chirimen-oh/echigo-release/README.md

# [release](https://github.com/chirimen-oh/release/releases)
This is [release](https://github.com/chirimen-oh/release/releases) repository for CHIRIMEN

[CHIRIMEN Open Hardware Project Home Page](http://chirimen-oh.github.io)
