chirimen-oh/echigo-release/hardware/README.md

Information required in order to manufacture CHIRIMEN hardware CMN2015-1 is founded here. 

- CMN2015-1_BOM.pdf : BOM (PDF)
- CMN2015-1_BOM.xlsx : BOM (Excel sheet)
- CMN2015-1_gerber.zip : Gerber data
- CMN2015-1_printPattern.pdf : Print pattern PDF
- CMN2015-1_schematic.pdf : Schematic PDF
- CMN2015-1.pcb : Source PCB file for PADS CAD.
- README.md : This file

Note: CAD DATA is published! 6.10.2016
