chirimen-oh/echigo-release/hardware/CMN2015-1_schematic.pdf

# 05.5V DC in/LED

# 07.USB/OTG/Crystal/Debug

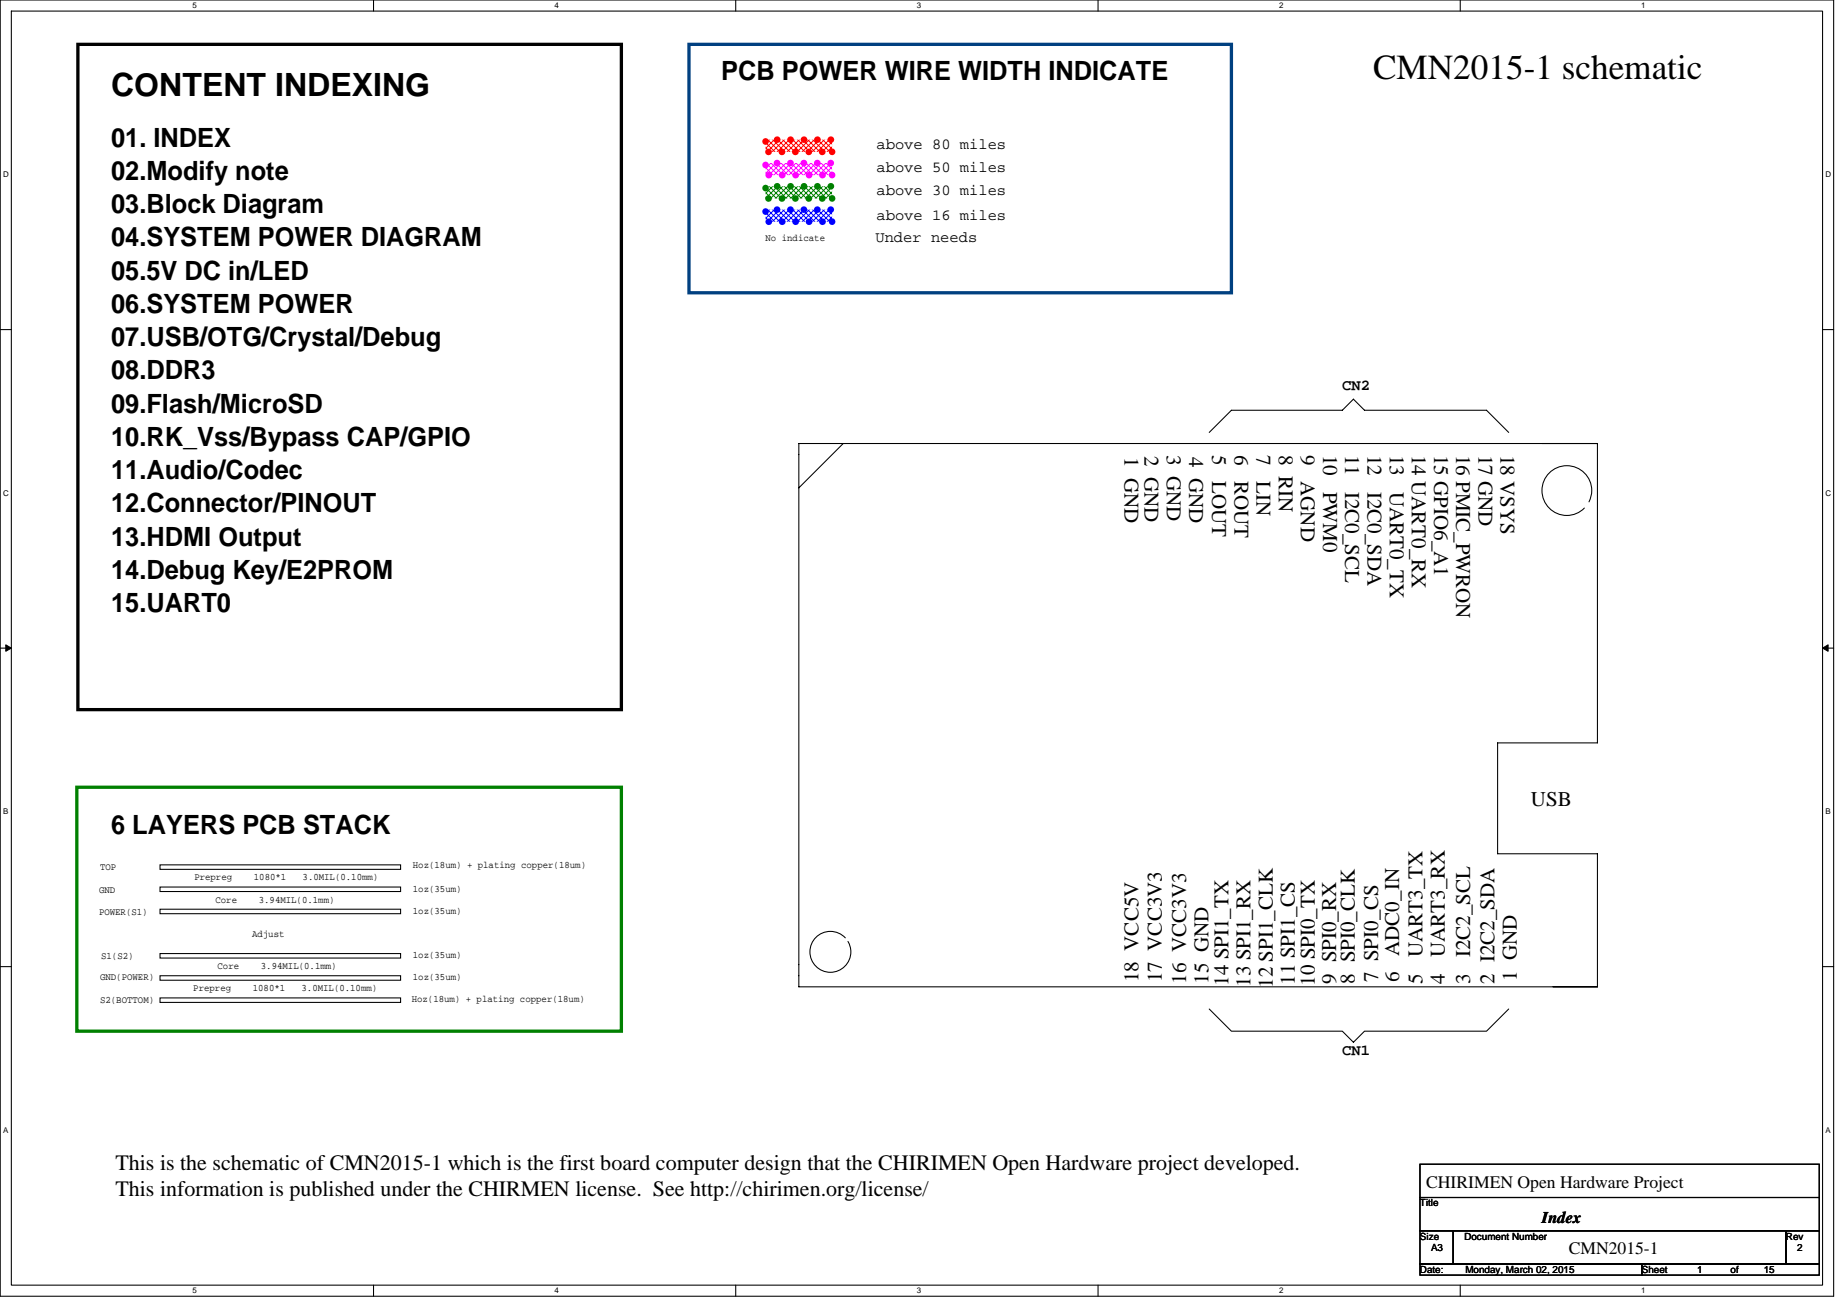
[picture p1: page 1]
06.SYSTEM POWER; above 80 miles above 50 miles; above 16 miles; above 30 miles; No indicate; Under needs; Prepreg; 3.0MIL(0.10mm); Core; 3.94MIL(0.1mm); Adjust; GND; GND(POWER); S2(BOTTOM); TOP; POWER(S1); 5 LOUT; 6 ROUT; 7 LIN; 8 RIN; 9 AGND; 10 PWM0; 11 I2C0_SCL; 12 I2C0_SDA; 13 UART0_TX; 14 UART0_RX; 15 GPIO6_A1; 16 PMIC_PWRON; 17 GND; 18 VSYS; 14 SPI1_TX; 13 SPI1_RX; 12 SPI1_CLK 11 SPI1_CS; 10 SPI0_TX 9 SPI0_RX; 8 SPI0_CLK 7 SPI0_CS; 6 ADC0_IN; 5 UART3_TX; 4 UART3_RX; 3 I2C2_SCL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

PCB POWER WIRE WIDTH INDICATE

CONTENT INDEXING
01. INDEX
02.Modify note
03.Block Diagram
04.SYSTEM POWER DIAGRAM

08.DDR3
09.Flash/MicroSD
10.RK_Vss/Bypass CAP/GPIO
11.Audio/Codec
12.Connector/PINOUT
13.HDMI Output
14.Debug Key/E2PROM
15.UART0

6 LAYERS PCB STACK

Hoz(18um) + plating copper(18um)

This is the schematic of CMN2015-1 which is the first board computer design that the CHIRIMEN Open Hardware project developed.
This information is published under the CHIRMEN license. See http://chirimen.org/license/

CHIRIMEN Open Hardware Project

Size A3 | Document Number CMN2015-1 | Rev

Date: Monday, March 02, 2015 Monday, March 02, 2015 Monday, March 02, 2015 | Sheet 1 1 1 of 15 15 15

D | D
C | C
B | B
A | A
Version | Date | Author | Change Note | Note
V1 | 20150108 | Dawen | First edictor
V2 | 20150302 | Dawen | INARI to CHIRIMEN, Add Power&Ground PIN

# Modify note

Monday, March 02, 2015 | 2 | 15

# Modify note

Monday, March 02, 2015 | 2 | 15

# Modify note

Monday, March 02, 2015 | 2 | 15

## CHIRIMEN Open Hardware Project

# SDIO1

I2C3

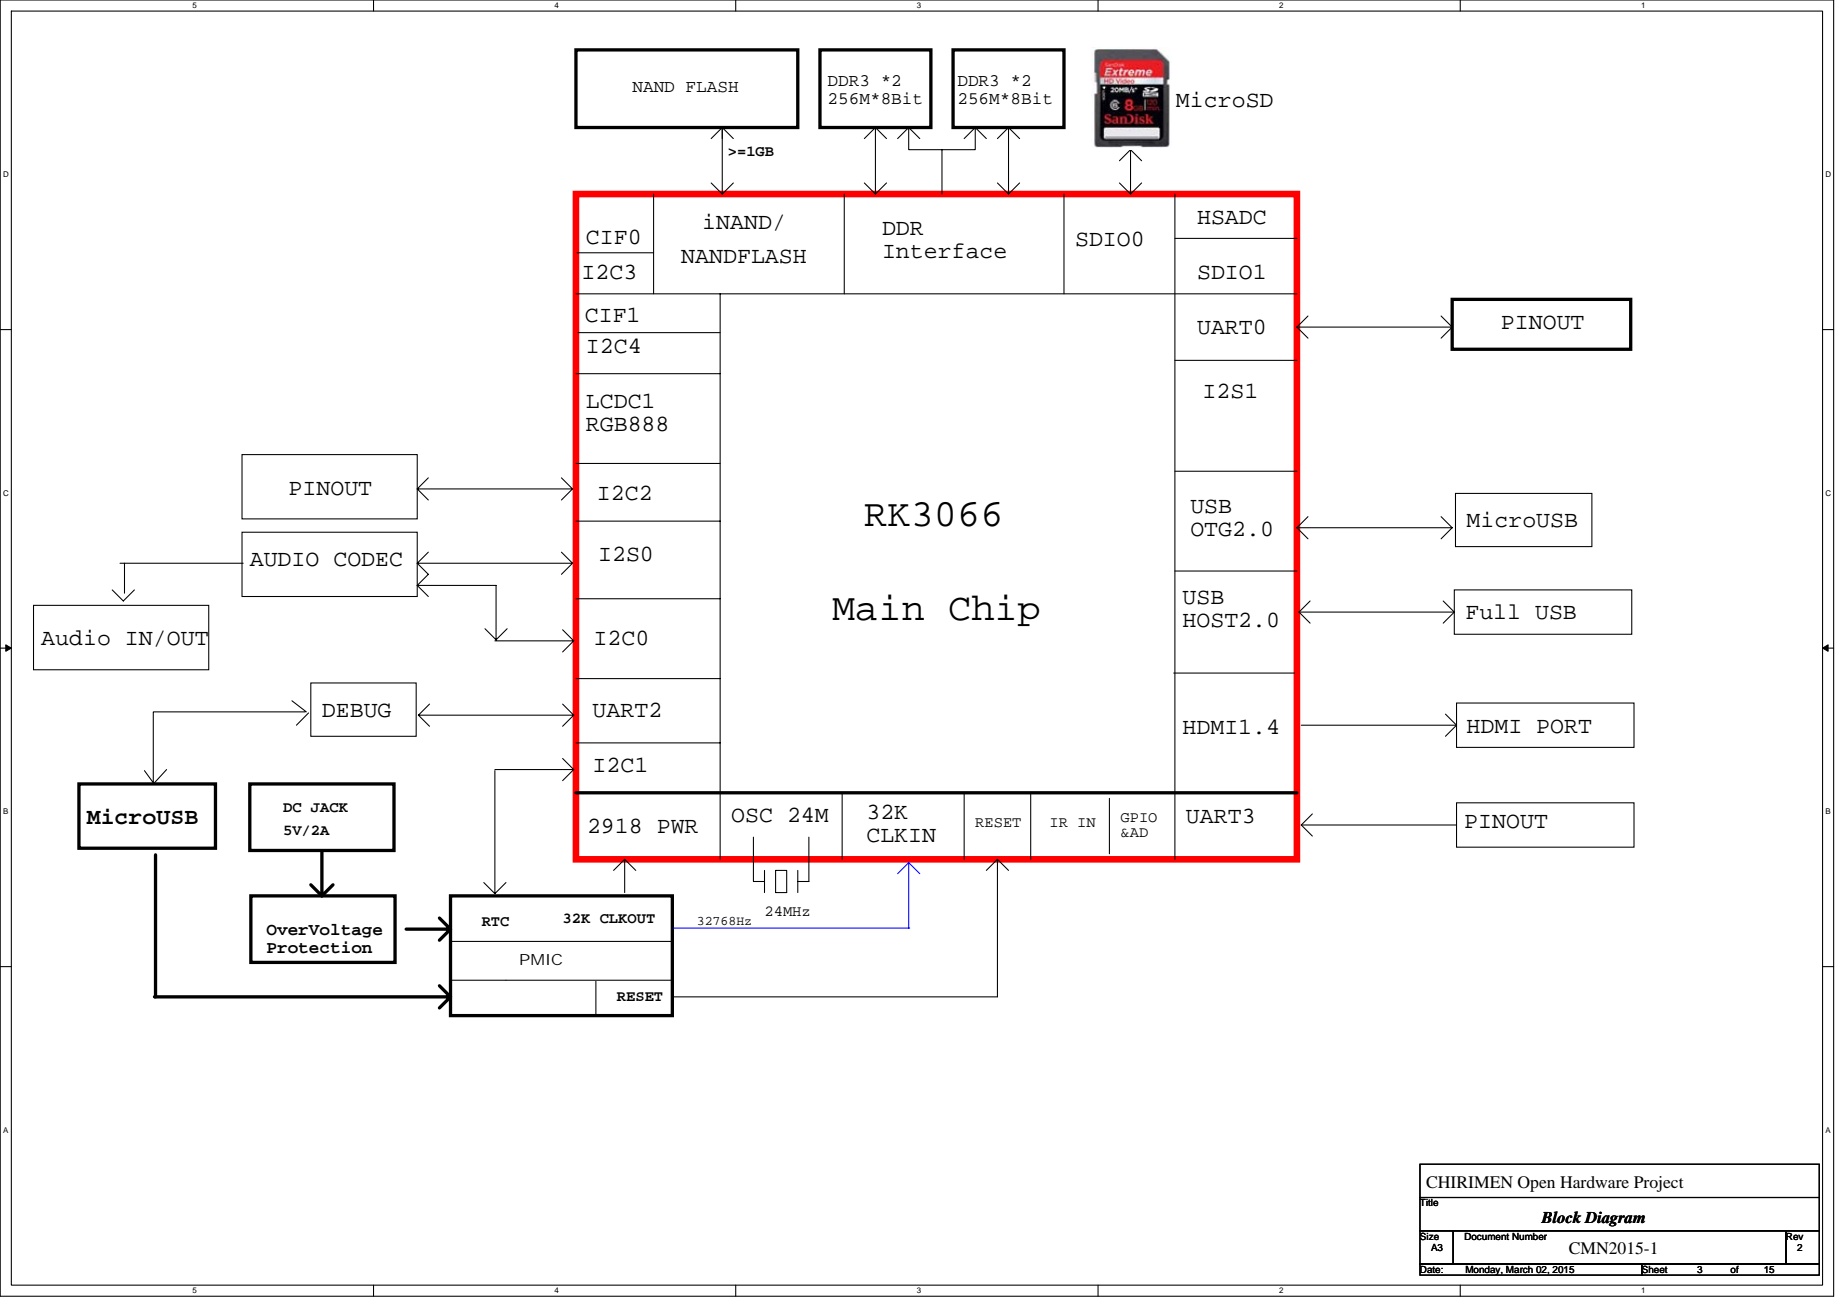
[picture p2: page 3]
2918 PWR; UART2; LCDC1 RGB888; NAND FLASH; DDR3 *2 256M*8Bit; 24MHz; OSC 24M; CLKIN; UART0; USB OTG2.0; iNAND/; RESET; USB HOST2.0; NANDFLASH; PMIC; DDR Interface; OverVoltage Protection; CIF0; SDIO0; HSADC; Full USB; CIF1 I2C4; PINOUT; AUDIO CODEC; DEBUG; DC JACK 5V/2A; RTC; 32K CLKOUT; HDMI1.4; HDMI PORT; GPIO; UART3; MicroUSB; Main Chip; MicroSD; Block Diagram; Monday, March 02, 2015

Audio IN/OUT

CHIRIMEN Open Hardware Project

## VDD1

VCC2 | DCDC | VDD2

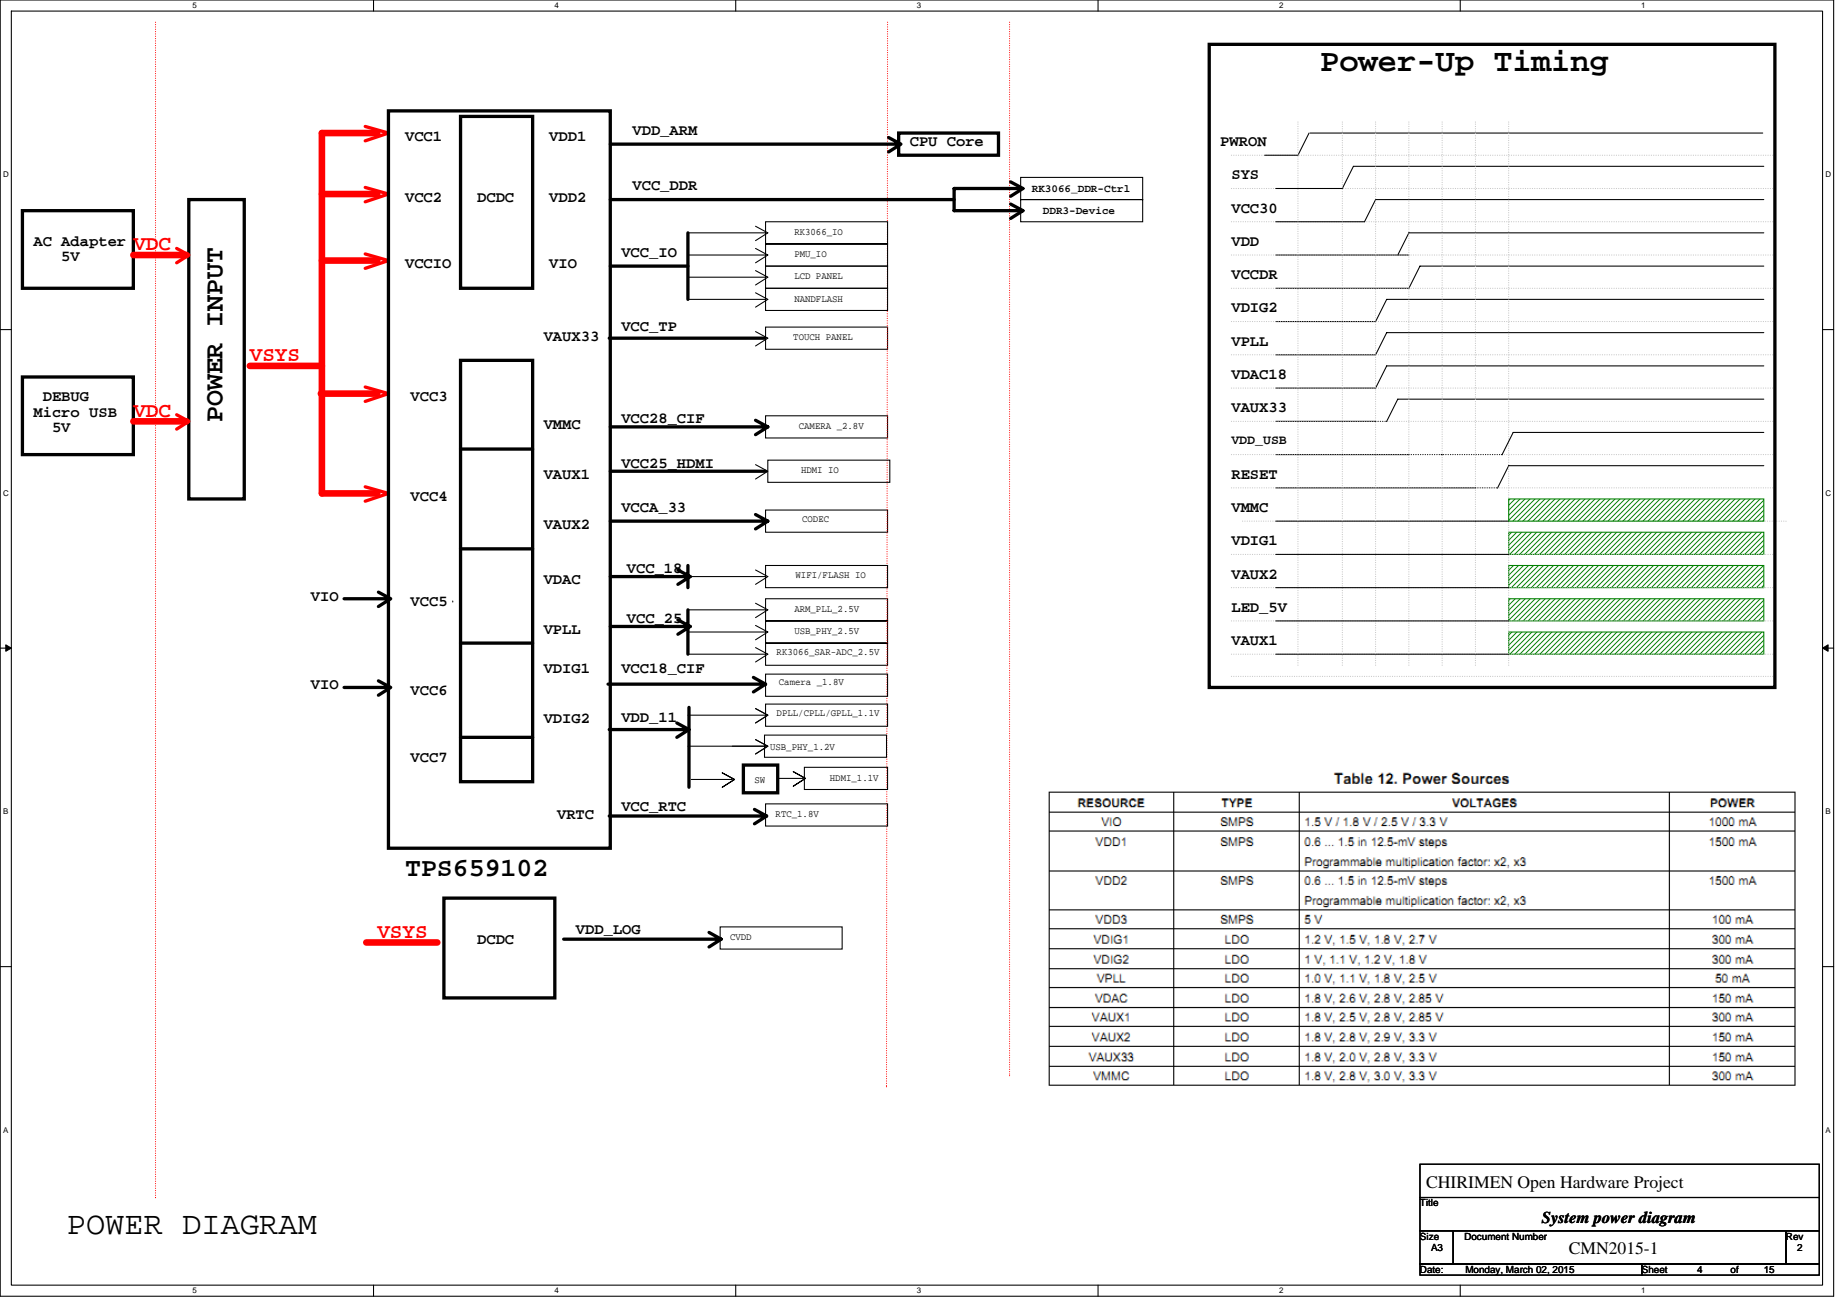
[picture p3: page 4]
POWER DIAGRAM; POWER INPUT; VCCIO; VIO; VSYS; USB_PHY_2.5V; ARM_PLL_2.5V; RK3066_SAR-ADC_2.5V; VCC_25; VCC25_HDMI; CODEC; VCCA_33; CAMERA _2.8V VCC28_CIF; TOUCH PANEL; VCC_TP; VAUX1; VCC_DDR; VDD_ARM; PMU_IO; NANDFLASH; VCC_IO AC Adapter 5V; TPS659102; VCC1; DDR3-Device; CPU Core; RK3066_DDR-Ctrl; VAUX2; VDIG1; VDIG2; VPLL; VMMC; VDAC18; VCCDR; VDD; VAUX33; PWRON; SYS; VCC30; VDD_USB; RESET; LED_5V VCC5; VDAC; VCC6; VCC4; VCC3; VCC7; VRTC; DPLL/CPLL/GPLL_1.1V; USB_PHY_1.2V; Camera _1.8V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

Power-Up Timing

WIFI/FLASH IO VCC_18

CHIRIMEN Open Hardware Project

System power diagram

# DC IN

## Note:

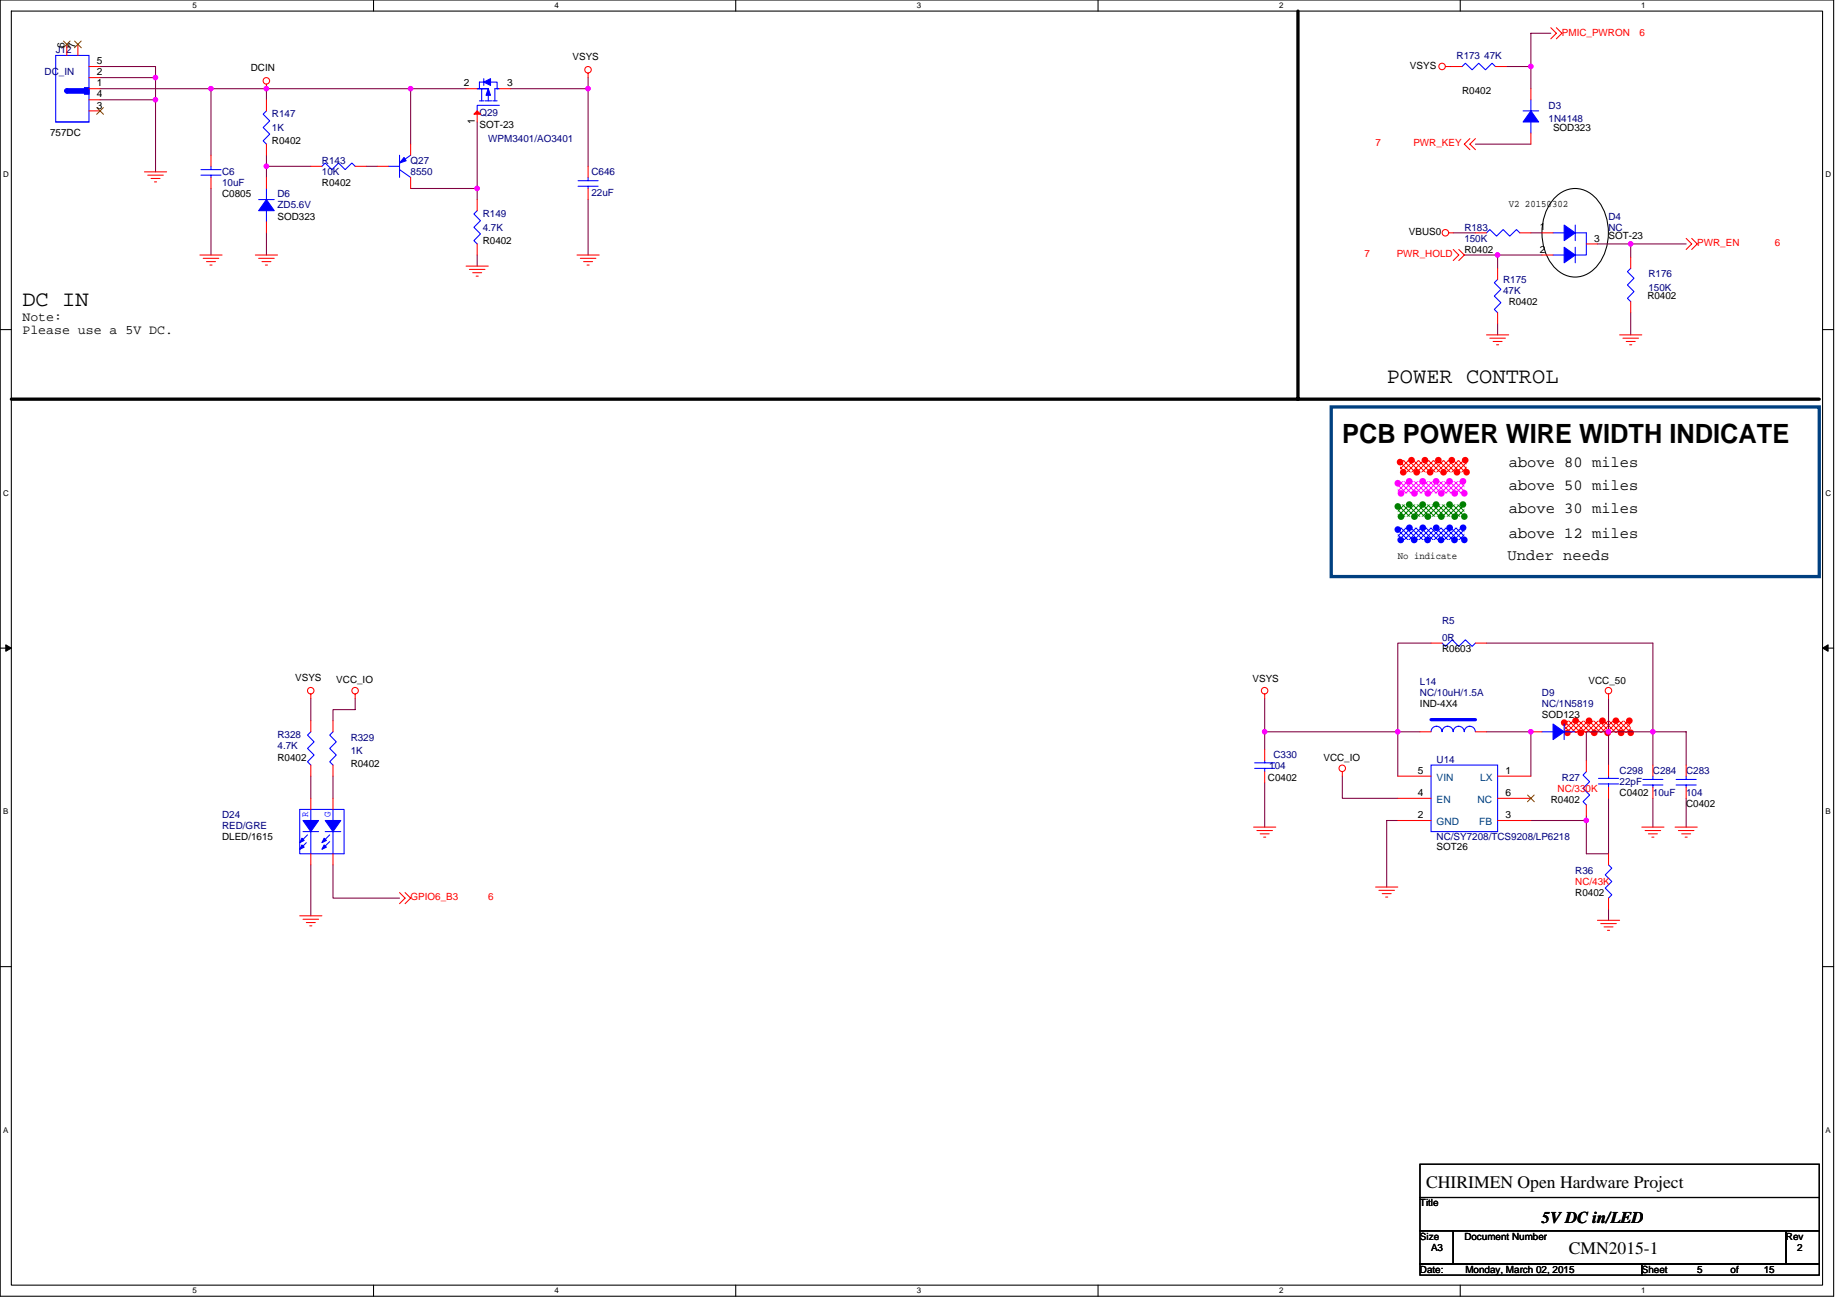
[picture p4: page 5]

POWER CONTROL
PCB POWER WIRE WIDTH INDICATE

CHIRIMEN Open Hardware Project

## above 30 miles

## above 50 miles

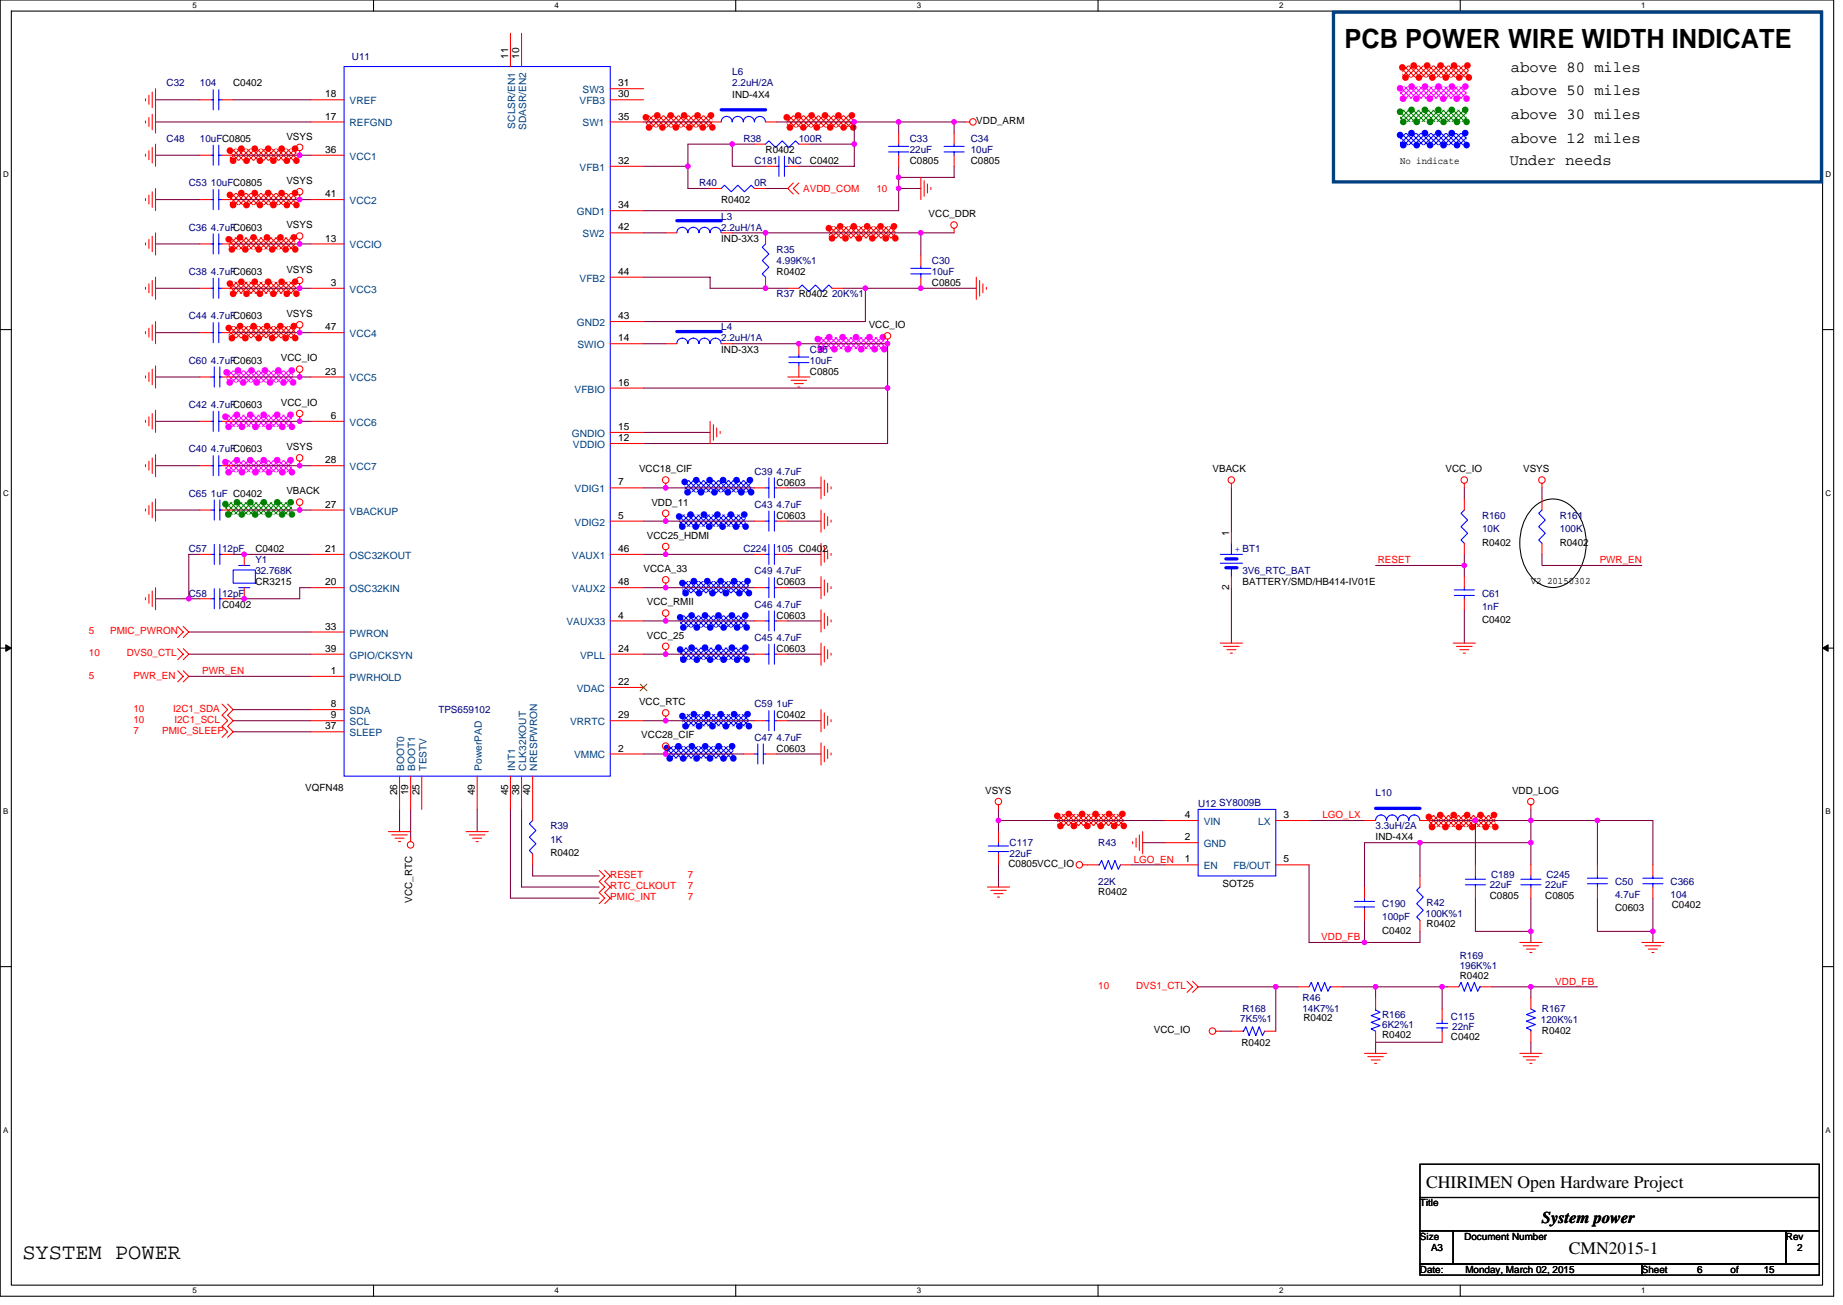
[picture p5: page 6]

PCB POWER WIRE WIDTH INDICATE

CHIRIMEN Open Hardware Project

When the system power on, the Adkey_in level is 0V, RK30 enter into recover mode.

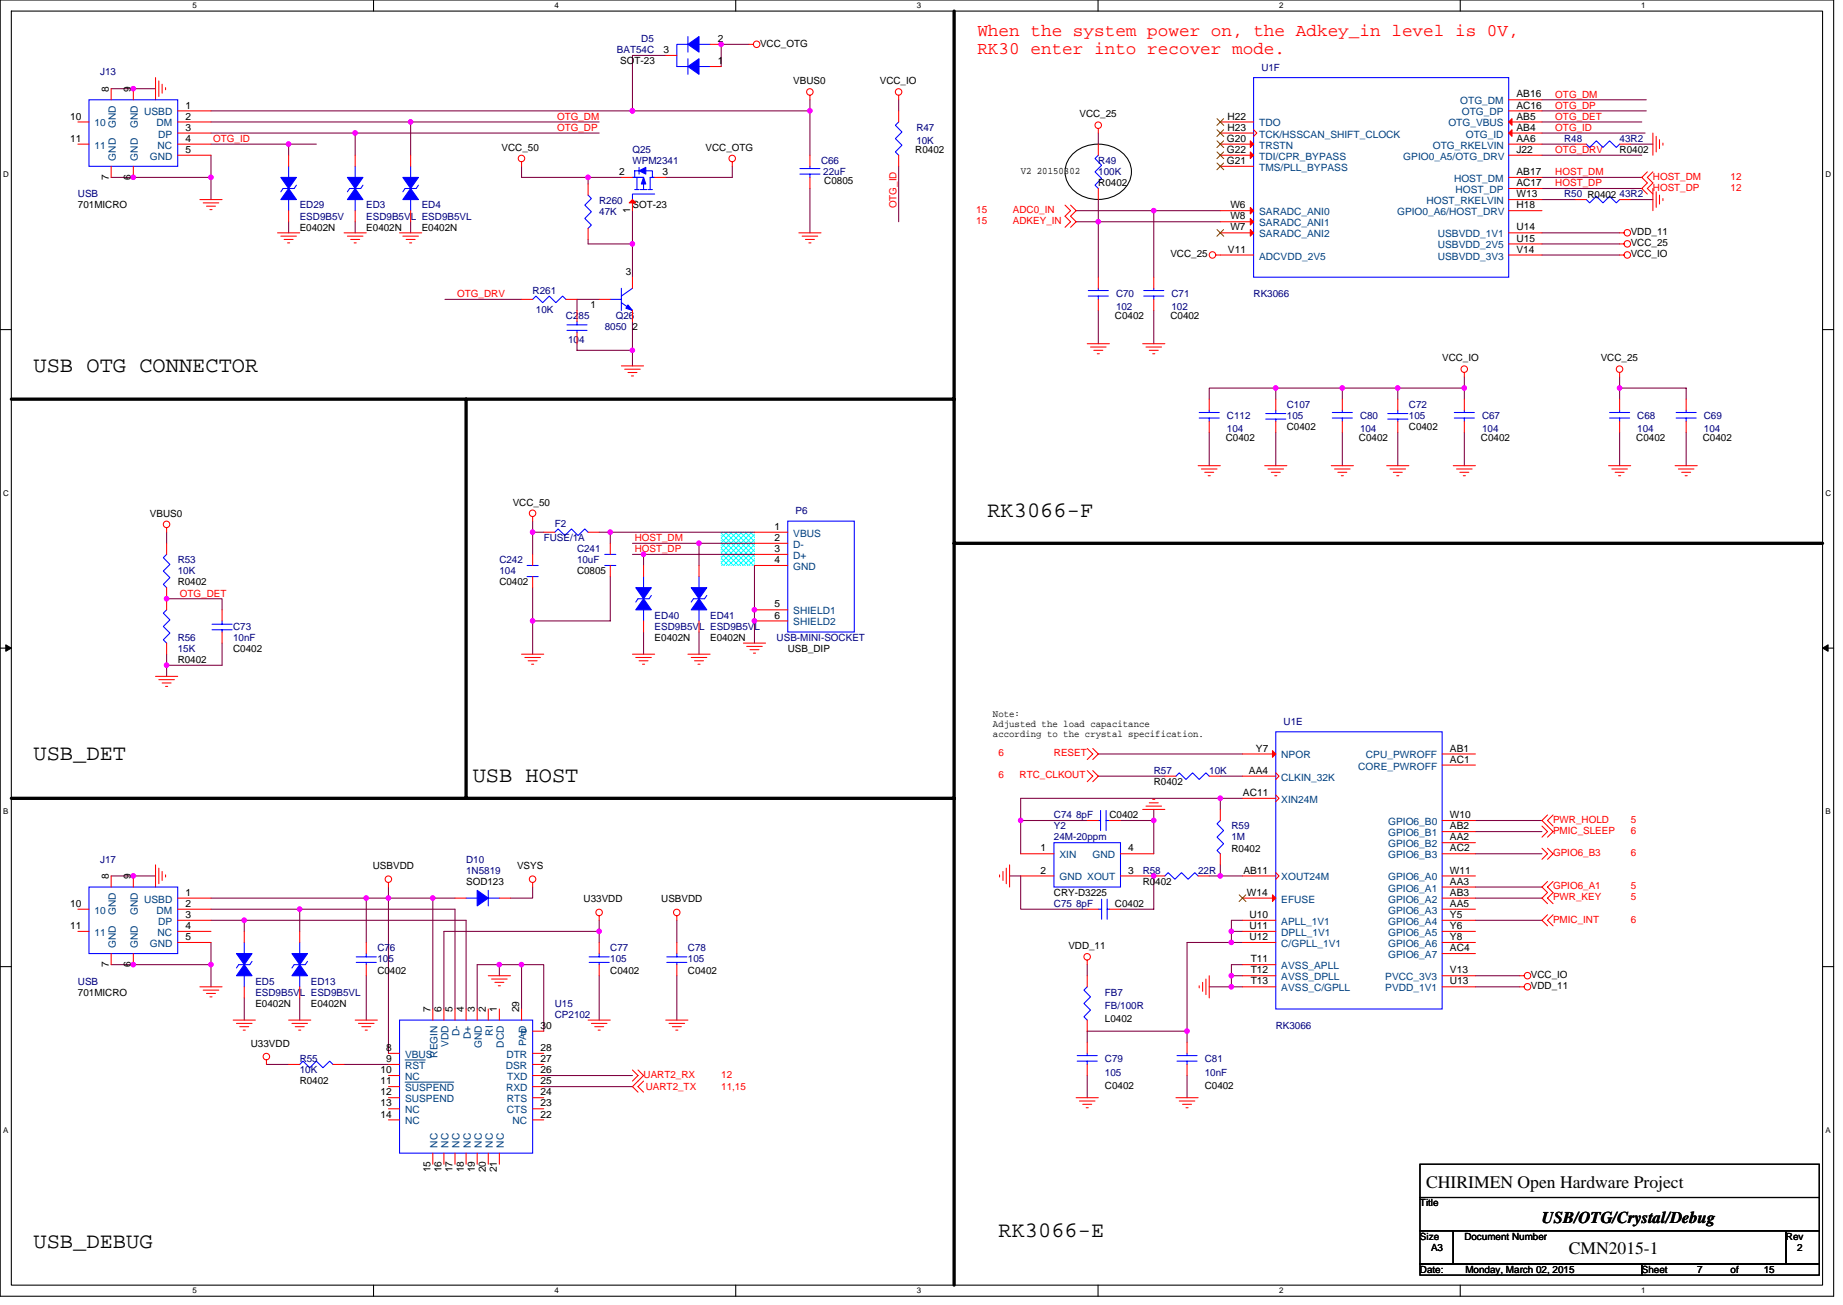
[picture p6: page 7]

HOST_DM | | D- 2

GND 4

Note:
Adjusted the load capacitance
according to the crystal specification.

1 RI 2 GND 3 D+ 4 D- 5 VDD 6 REGIN 7 VBUS 8

CHIRIMEN Open Hardware Project

USB/OTG/Crystal/Debug

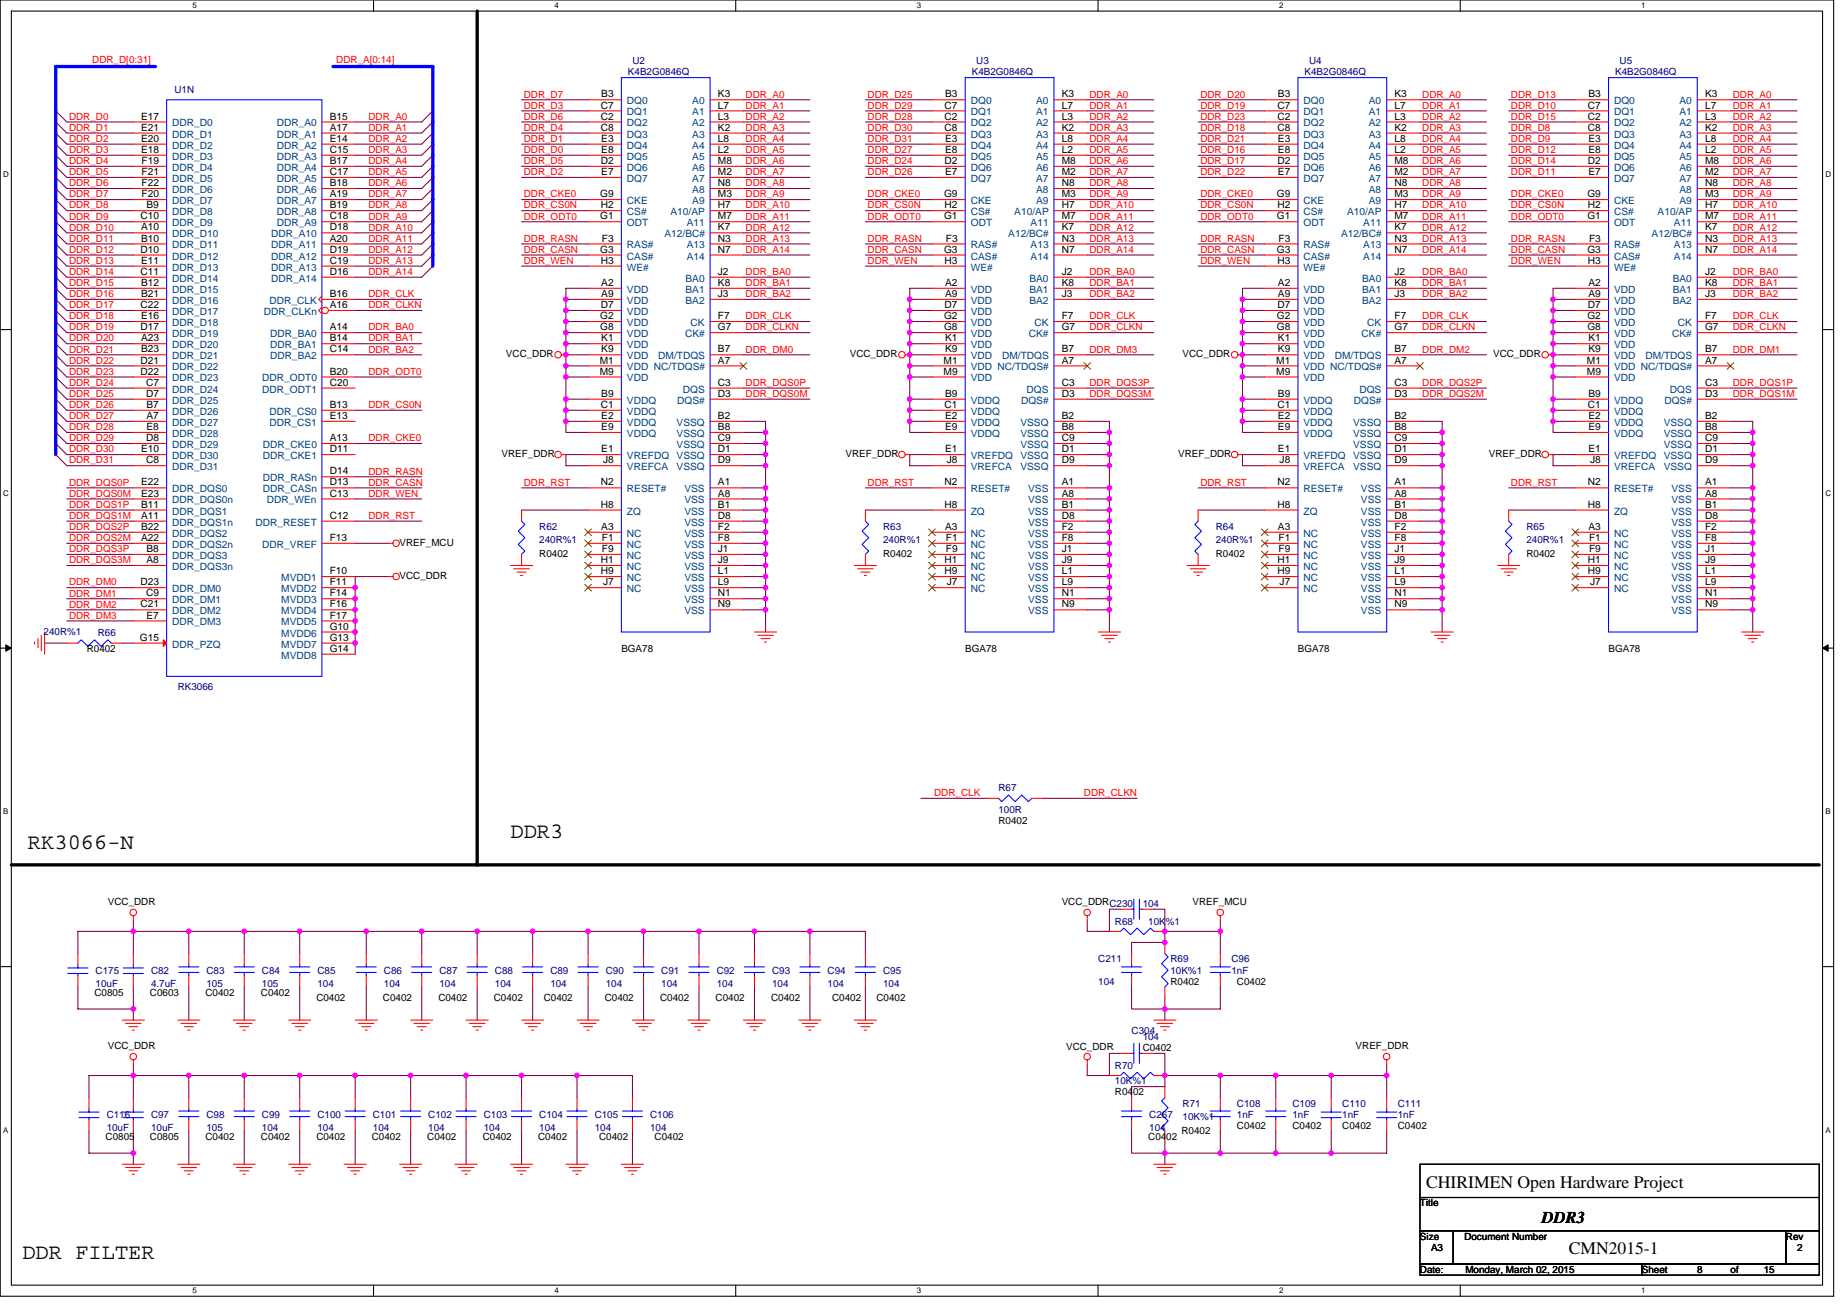
[picture p7: page 8]

CHIRIMEN Open Hardware Project

# RK3066-H

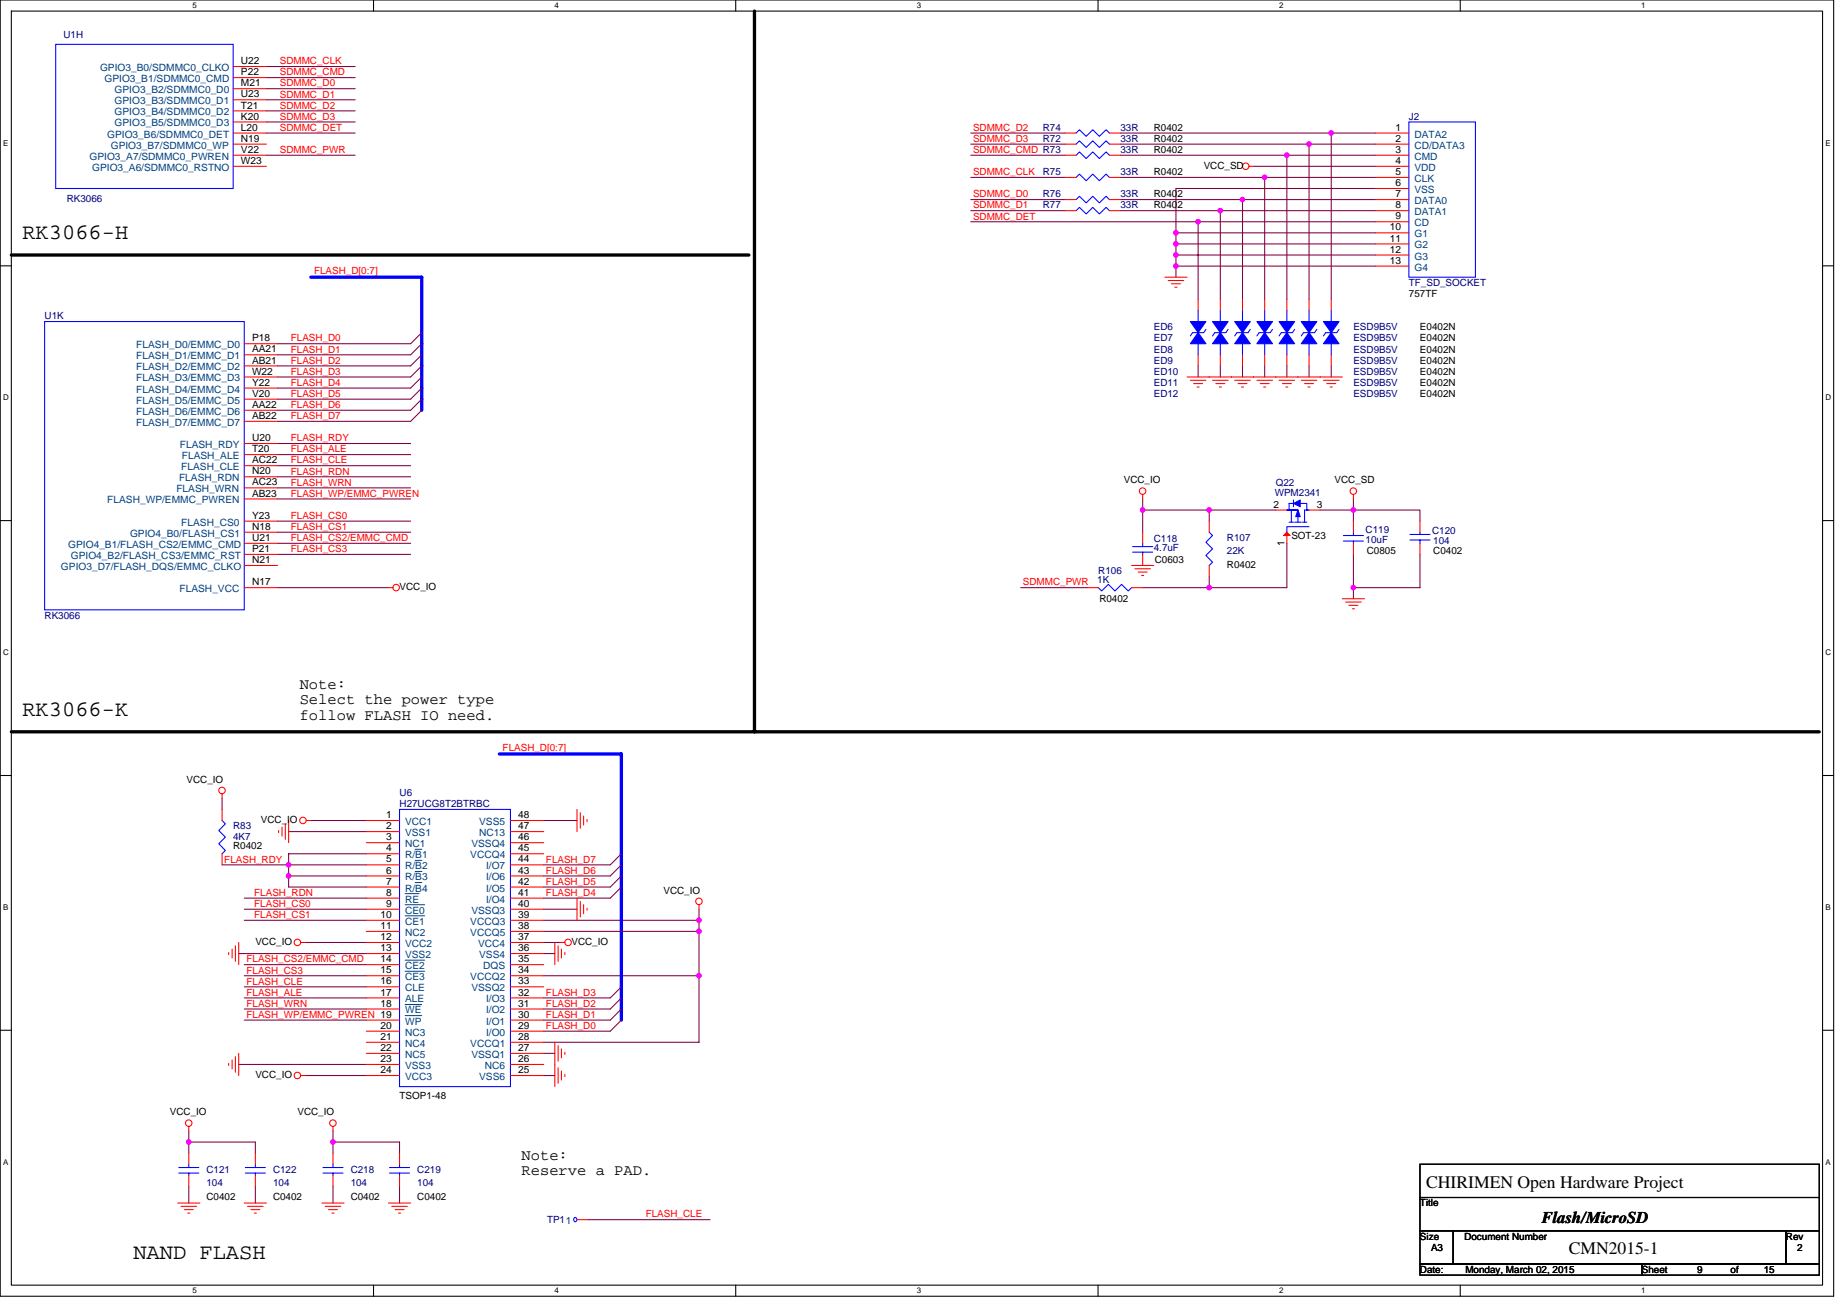
[picture p8: page 9]

Note:
Select the power type
follow FLASH IO need.

CHIRIMEN Open Hardware Project

# RK3066-G

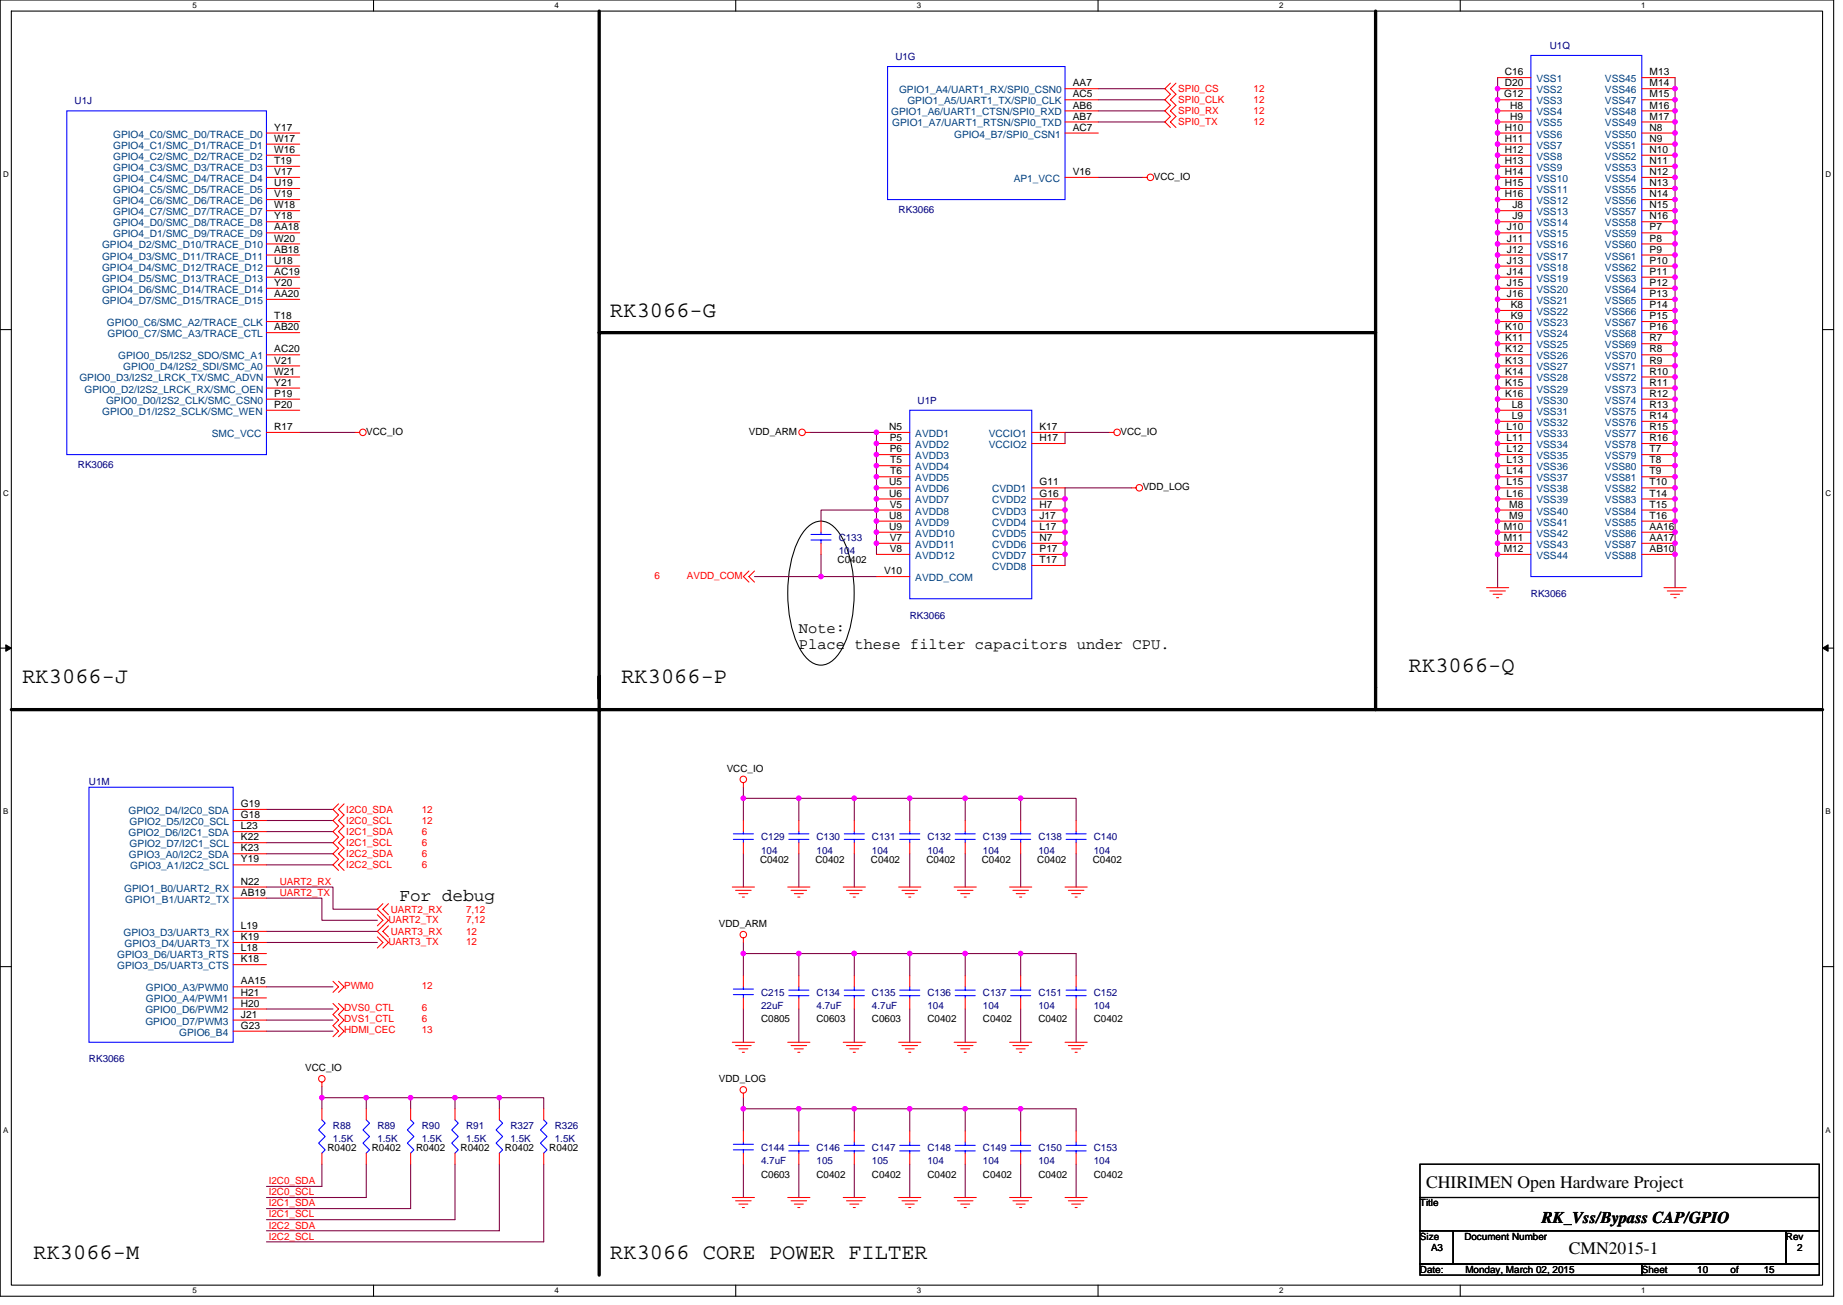
[picture p9: page 10]

Note:
Place these filter capacitors under CPU.

CHIRIMEN Open Hardware Project

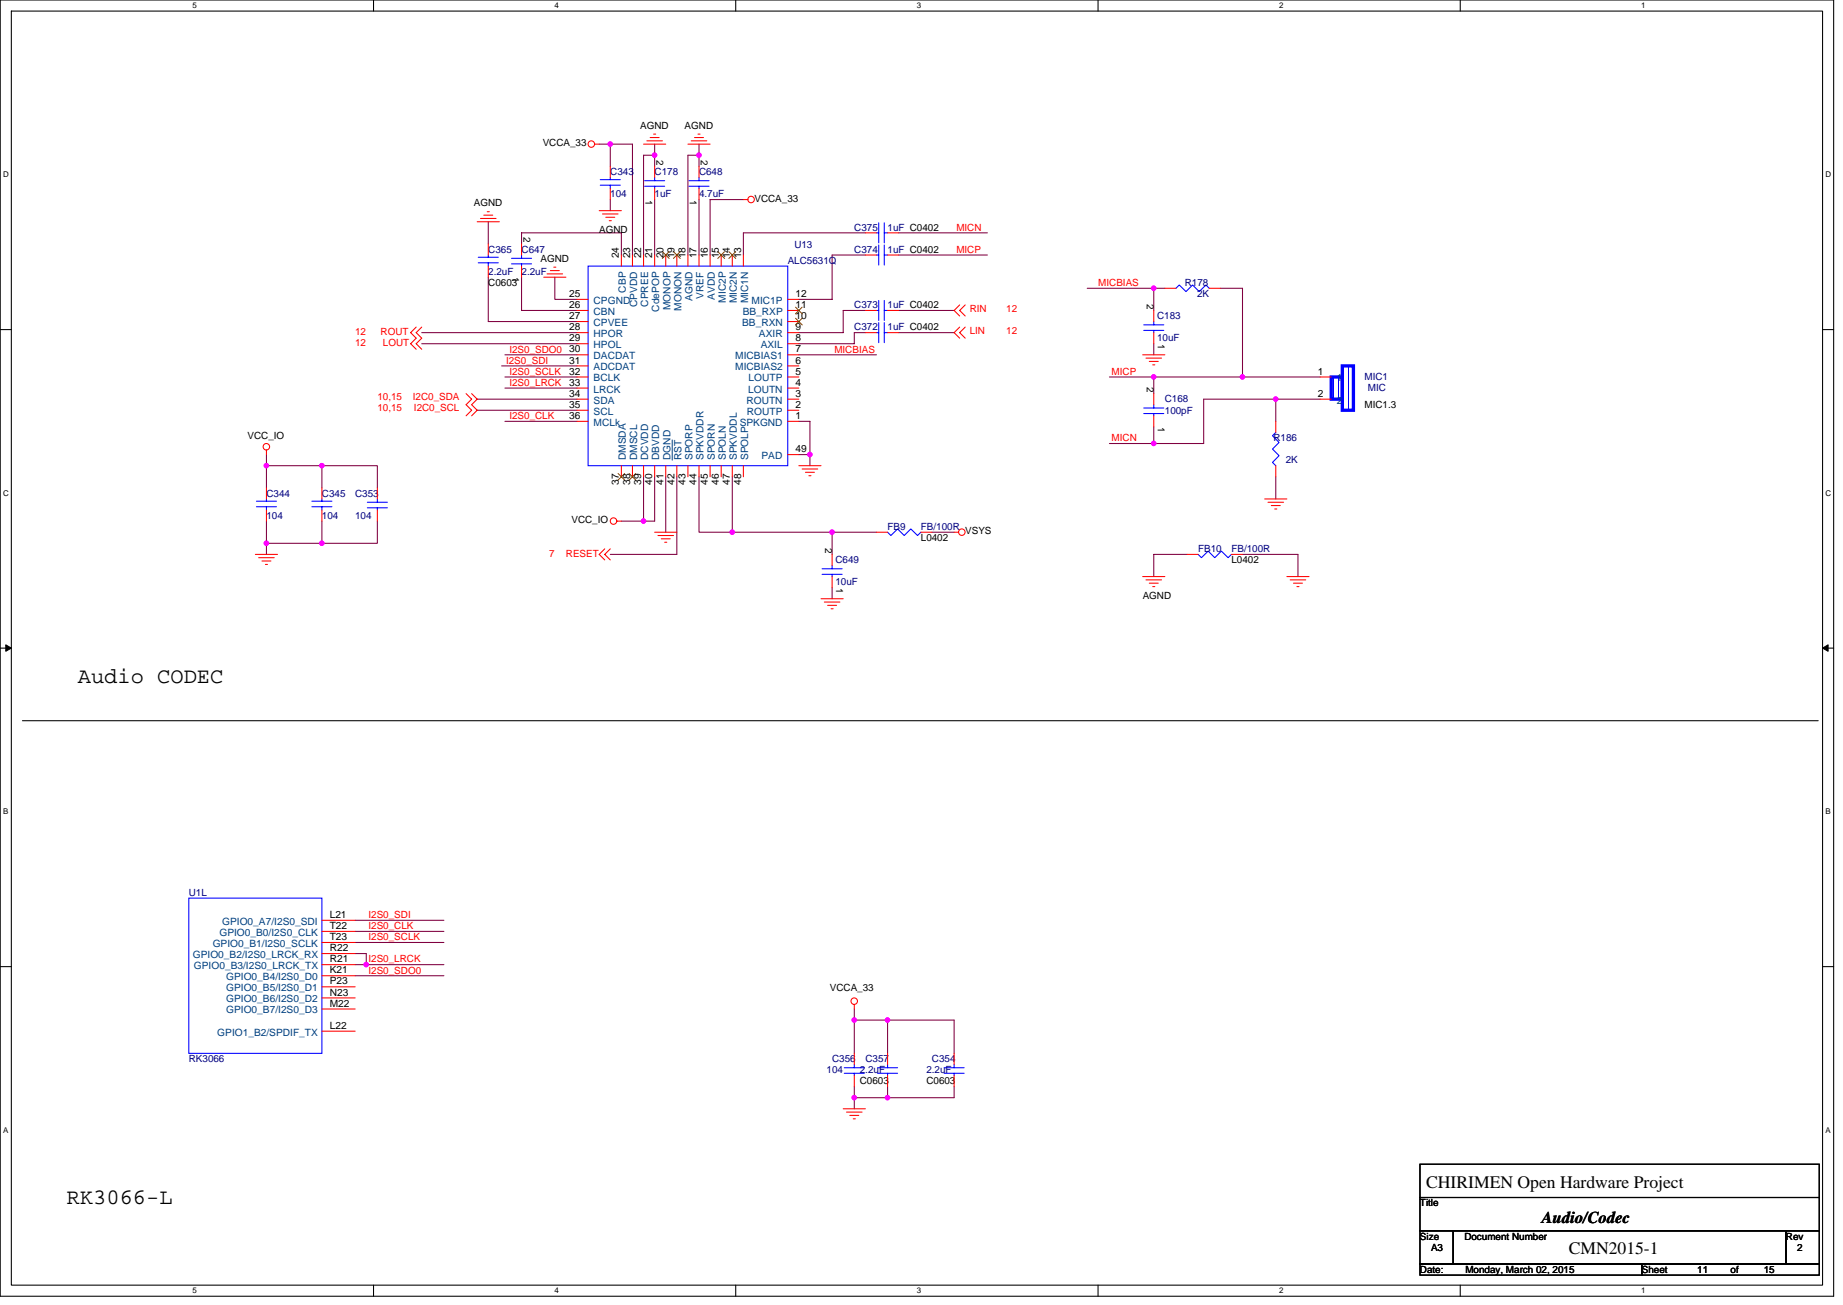
[picture p10: page 11]

CHIRIMEN Open Hardware Project

# DIP Connector

## I2C BUS

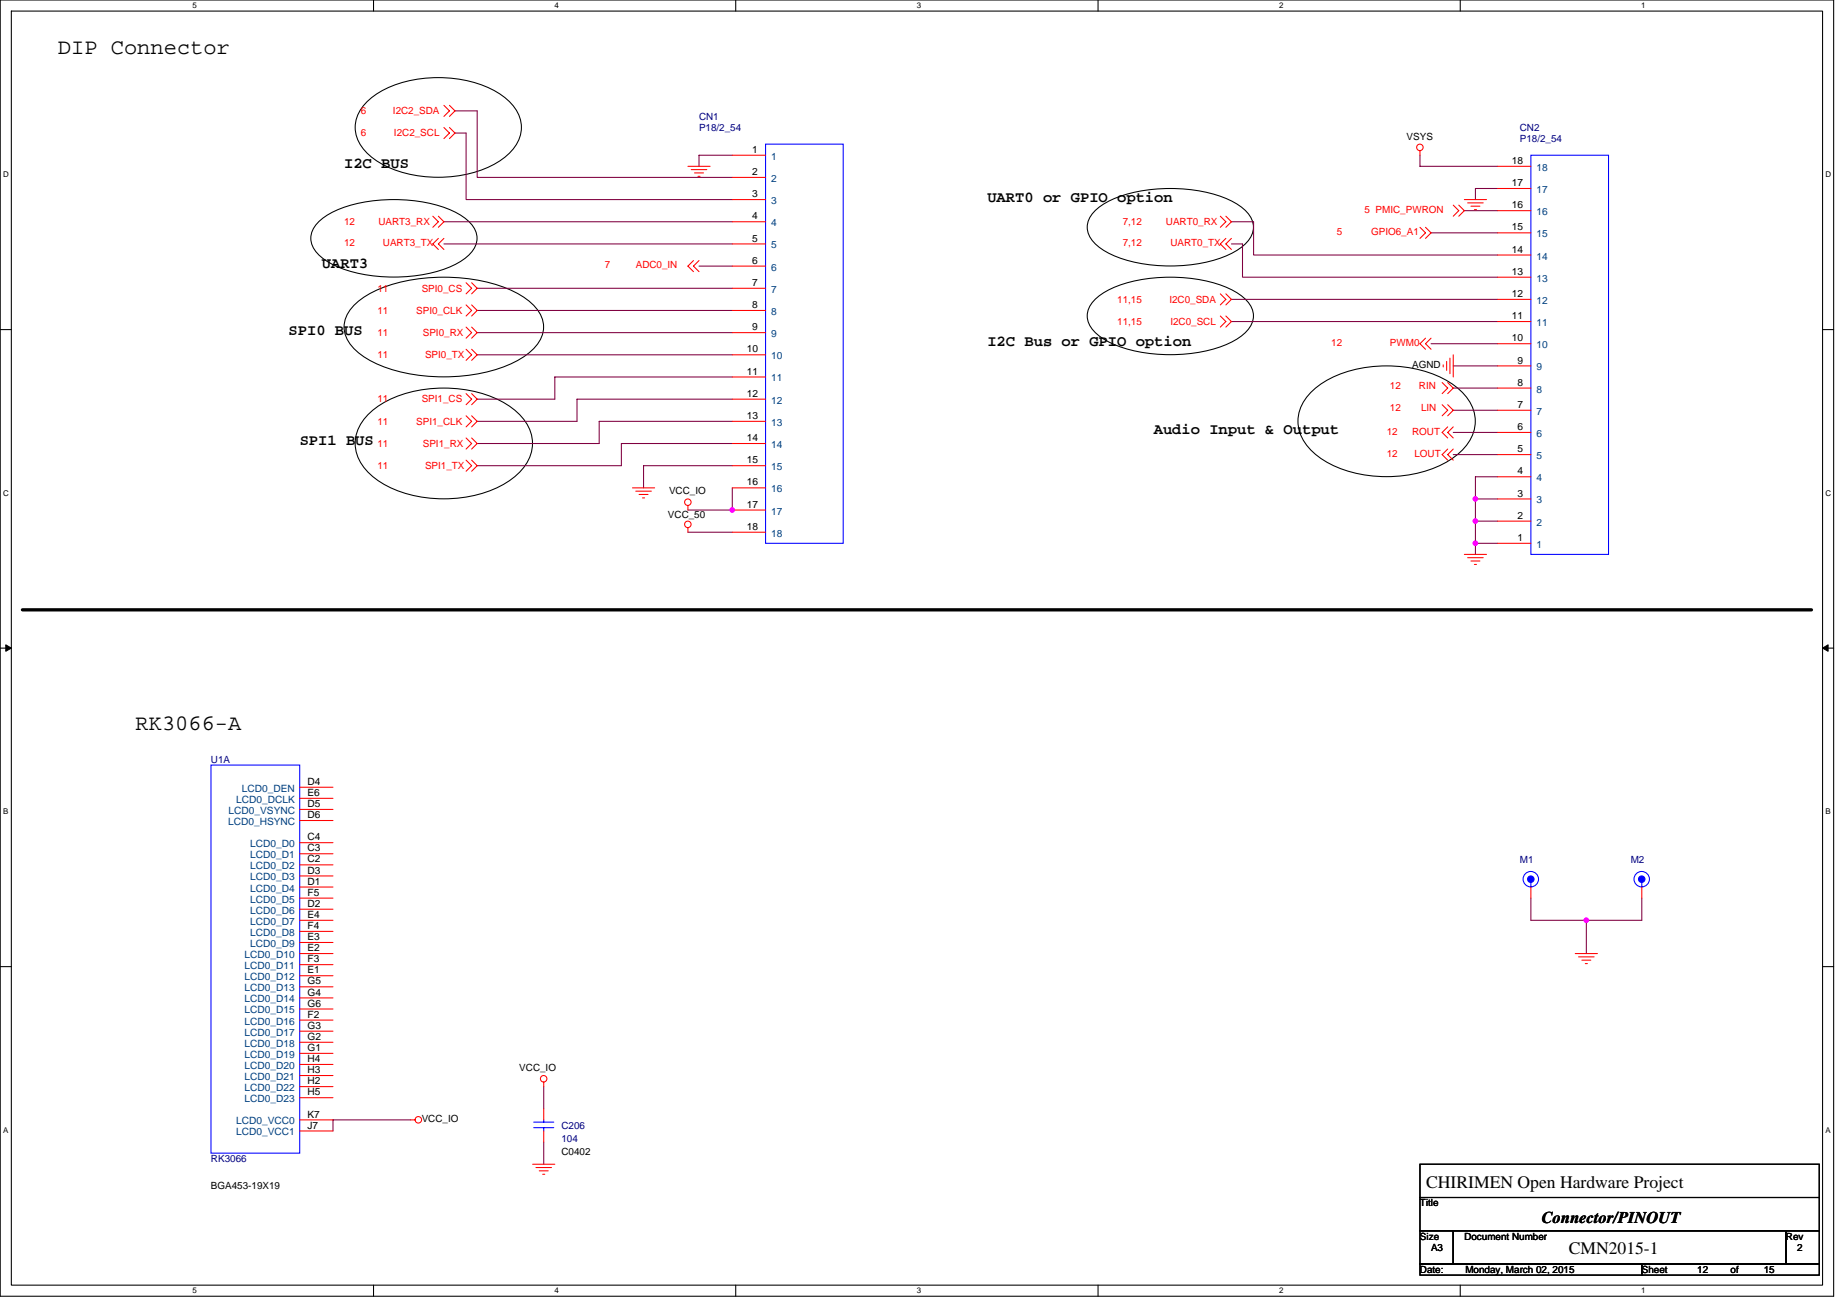
[picture p11: page 12]

I2C Bus or GPIO option

CHIRIMEN Open Hardware Project

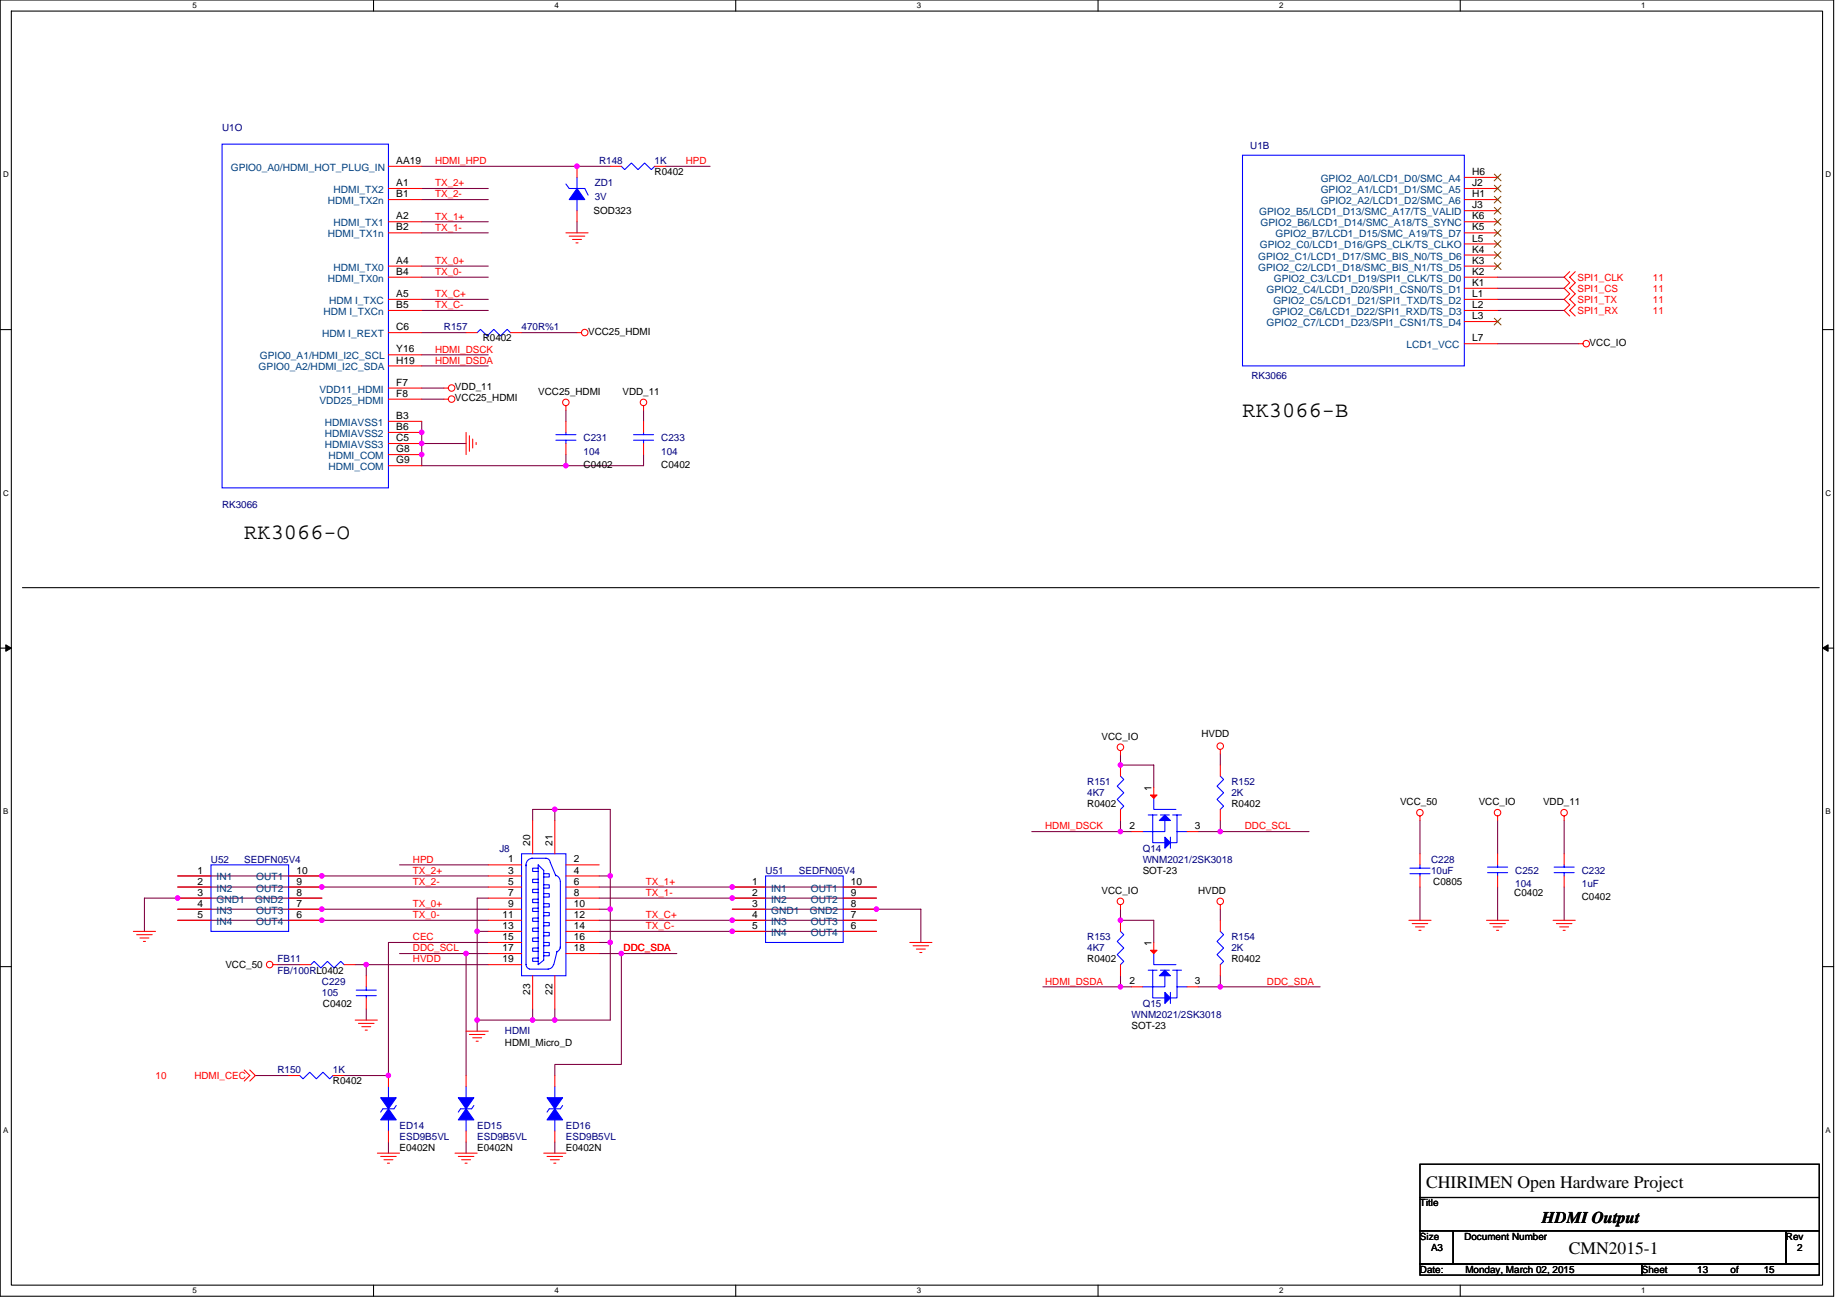
[picture p12: page 13]

CHIRIMEN Open Hardware Project

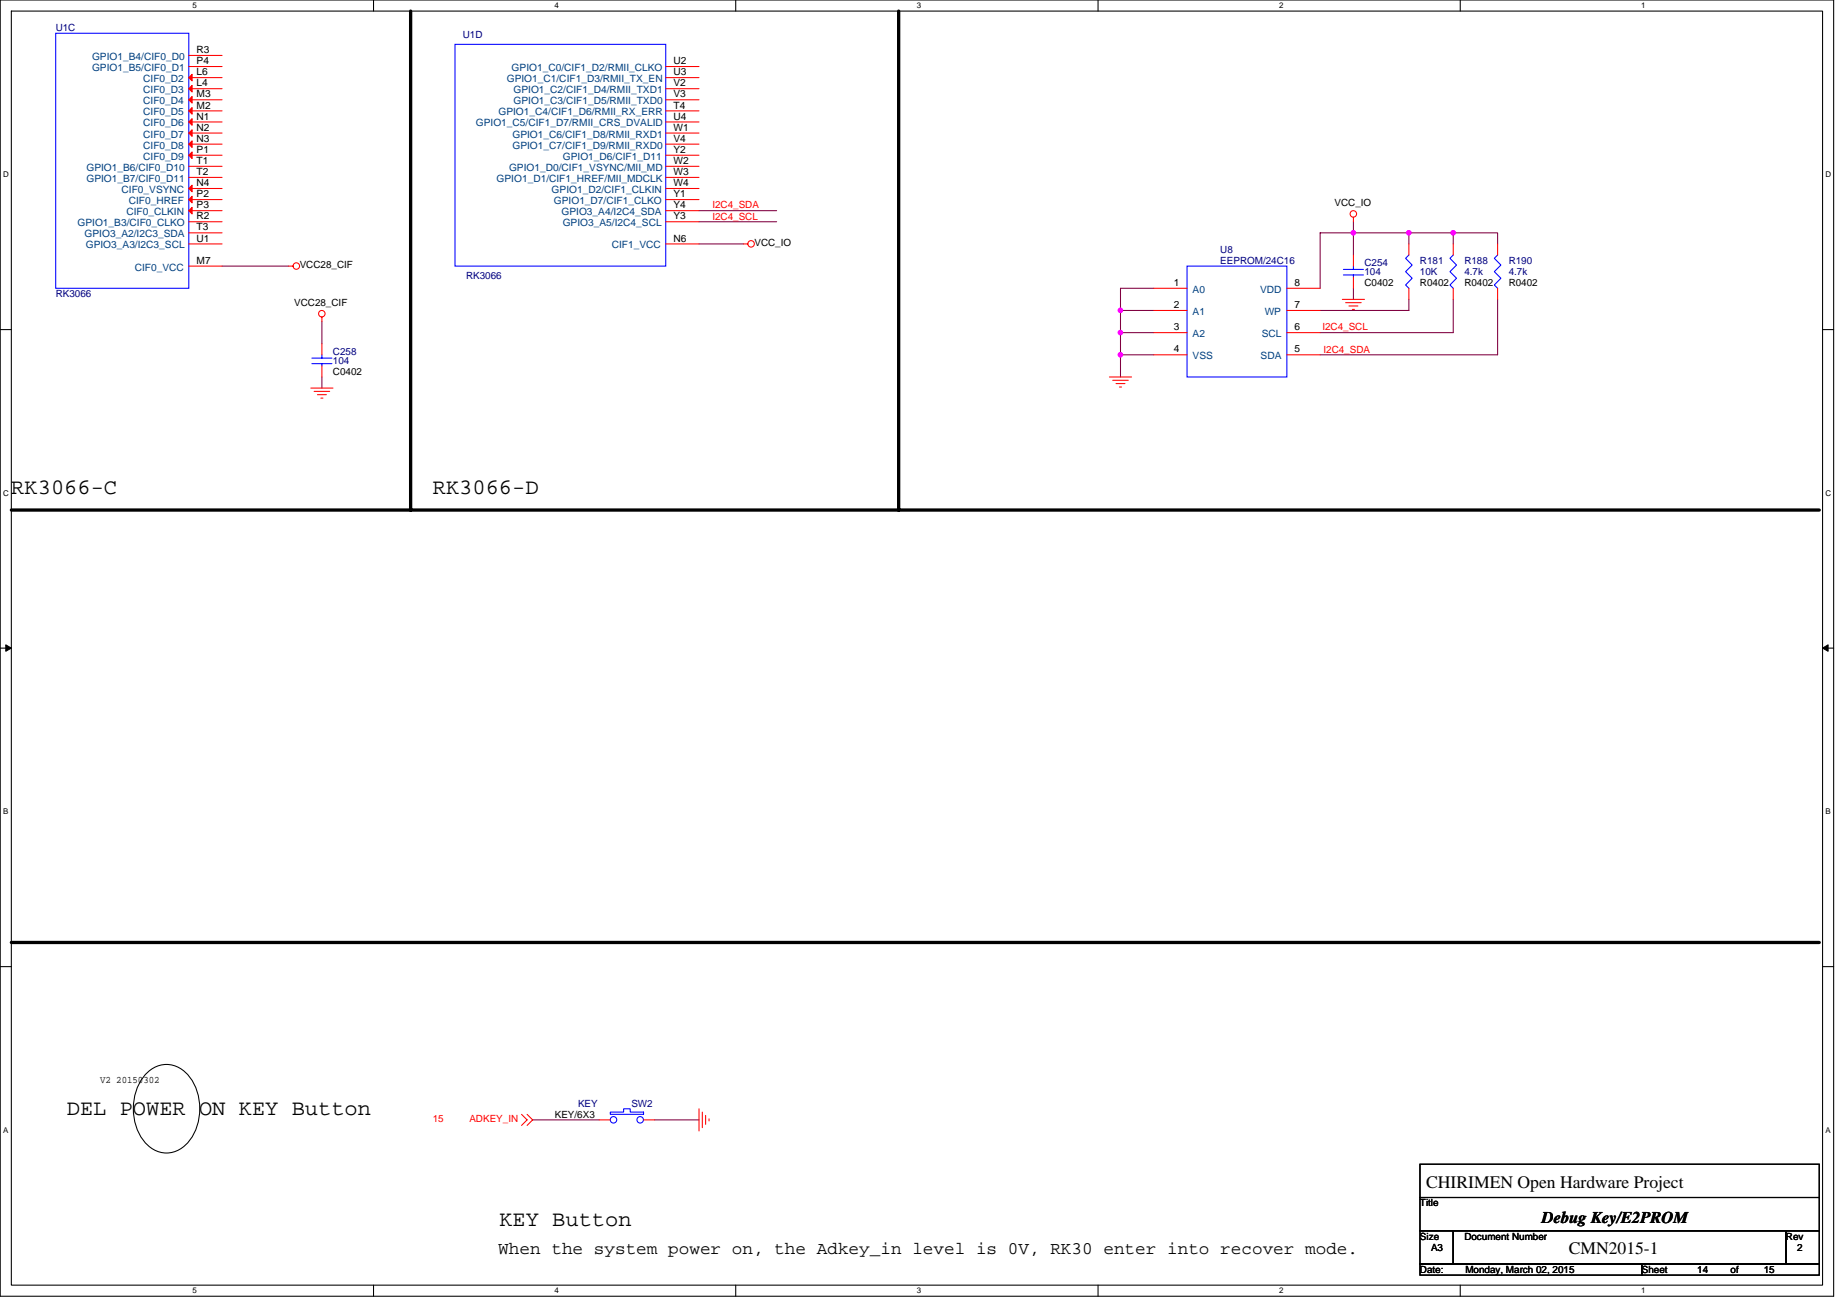
[picture p13: page 14]

A2 3 | I2C4_SCL

VSS 4 | I2C4_SDA

DEL POWER ON KEY Button

CHIRIMEN Open Hardware Project

KEY Button
When the system power on, the Adkey_in level is 0V, RK30 enter into recover mode.

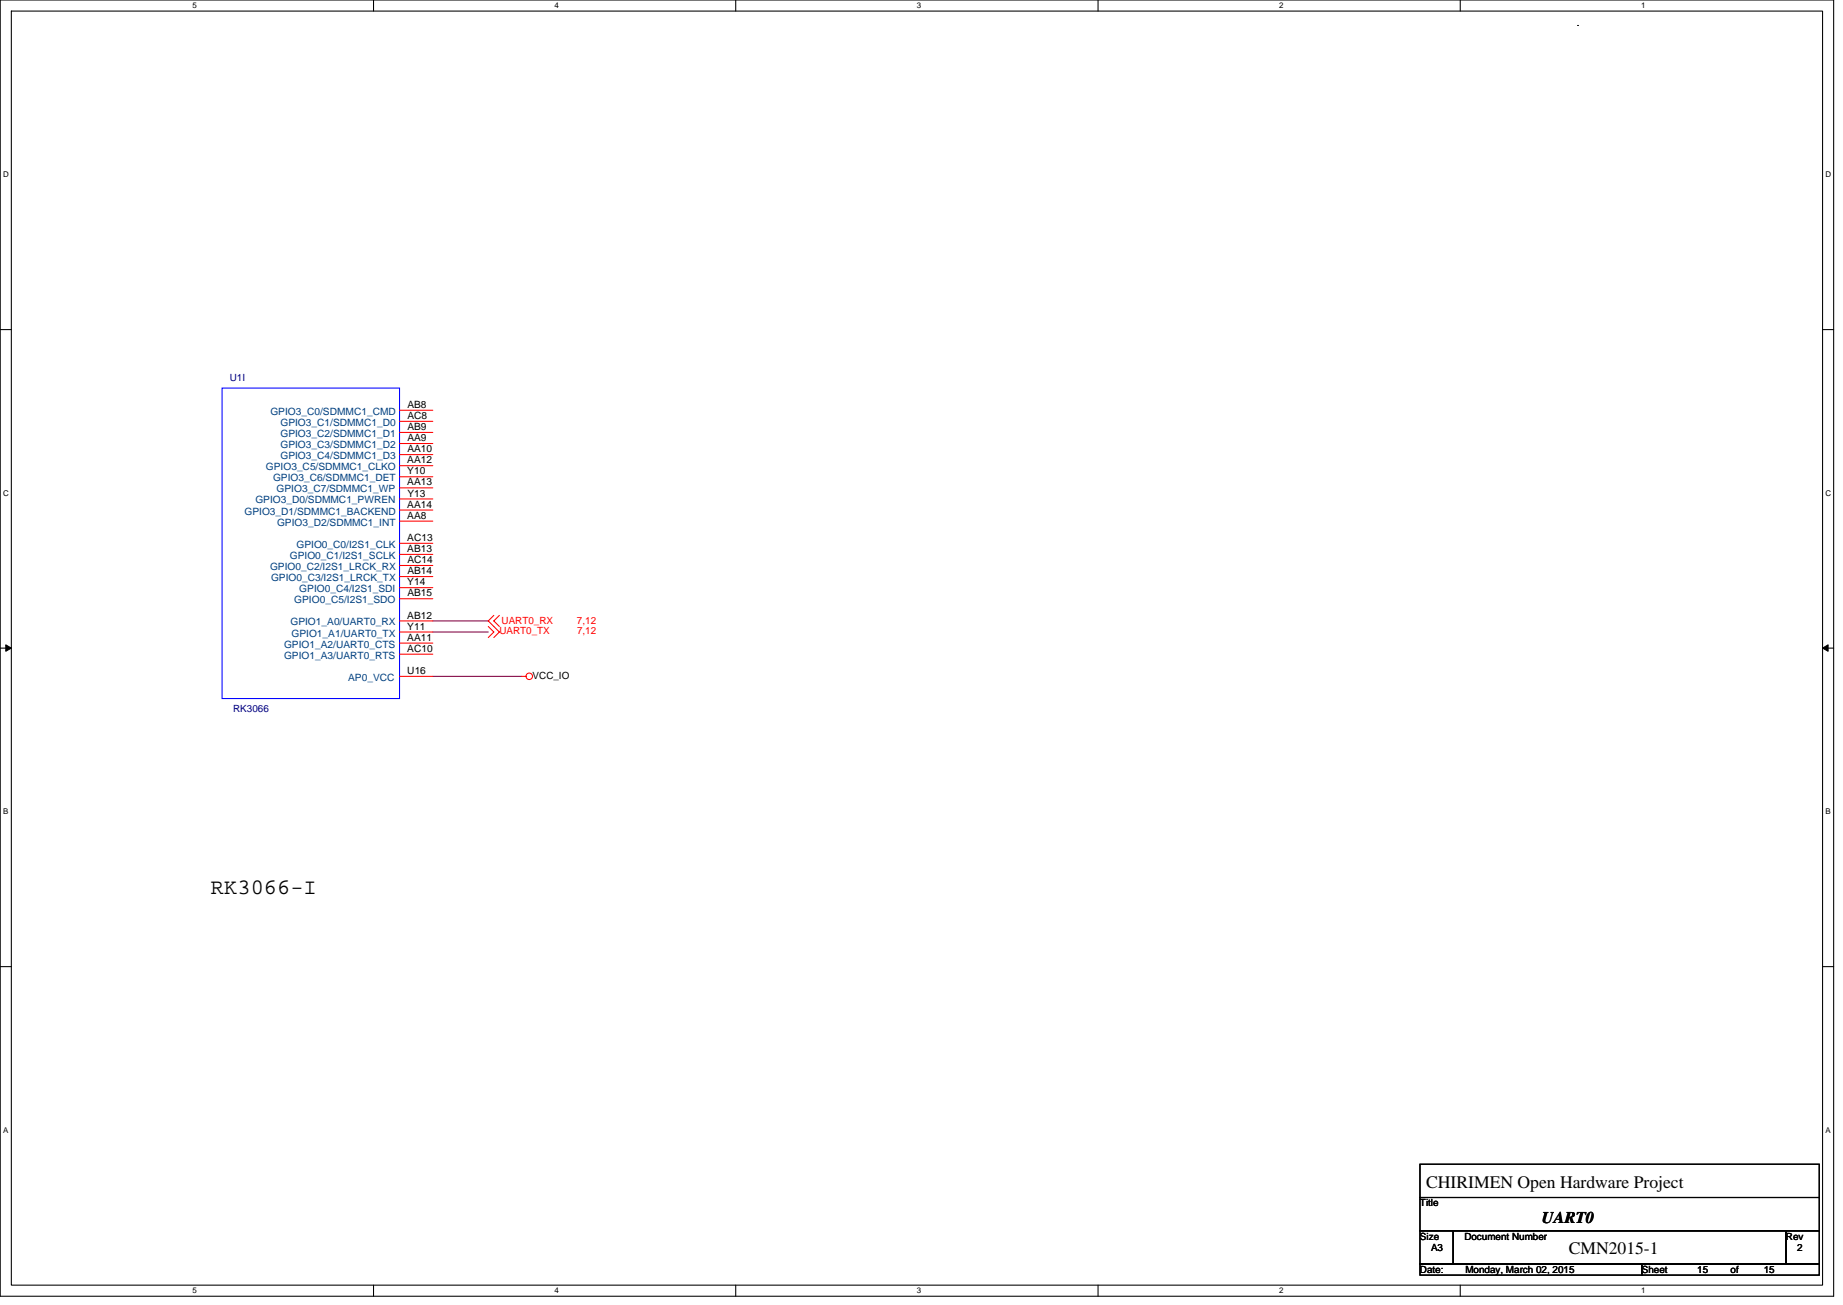
[picture p14: page 15]
VCC_IO; UART0_TX; UART0_RX; UART0; Monday, March 02, 2015; GPIO1_A0/UART0_RX; GPIO1_A1/UART0_TX; GPIO1_A2/UART0_CTS; GPIO1_A3/UART0_RTS; GPIO3_C5/SDMMC1_CLKO; GPIO3_C0/SDMMC1_CMD; GPIO3_C1/SDMMC1_D0; GPIO3_C2/SDMMC1_D1; GPIO3_C3/SDMMC1_D2; GPIO3_C4/SDMMC1_D3; GPIO3_C6/SDMMC1_DET; GPIO3_C7/SDMMC1_WP; GPIO3_D0/SDMMC1_PWREN; GPIO3_D1/SDMMC1_BACKEND; GPIO3_D2/SDMMC1_INT; GPIO0_C0/I2S1_CLK; GPIO0_C1/I2S1_SCLK; GPIO0_C2/I2S1_LRCK_RX; GPIO0_C3/I2S1_LRCK_TX; GPIO0_C4/I2S1_SDI; GPIO0_C5/I2S1_SDO; AP0_VCC

CHIRIMEN Open Hardware Project
