chirimen-oh/echigo-release/hardware/CMN2015-1_printPattern.pdf

Layer name on schematics | Gerber file name | Page
TopSolder | smd001023 | 2
TopSilkPrint | sst001026 | 3
TopRegist | sm001021 | 4
Top | art001 | 5
GND | art002 | 6
POWER(S1) | art003 | 7
S1(S2) | art004 | 8
GND(POWER) | art005 | 9
S2(BOTTOM) | art006 | 10
BottomRegist | sm006028 | 11
BottomSilkPrint | ssb006029 | 12
BottomSolder | smd006022 | 13
Drilling | dd001024 & drl001 | 14, 15

# The print pattern of CMN2015-1

## This document presents the print pattern of CMN2015-1 which is the first board computer design that the CHIRIMEN Open Hardware project developed. Gerber data is released

separately.

## This document is published under the

CHIRMEN license.

## http://chirimen.org/license/

# Table of contents

Copyright 2016 by Mozilla Japan All Rights Reserved

## CHIRIMEN Open Hardware project

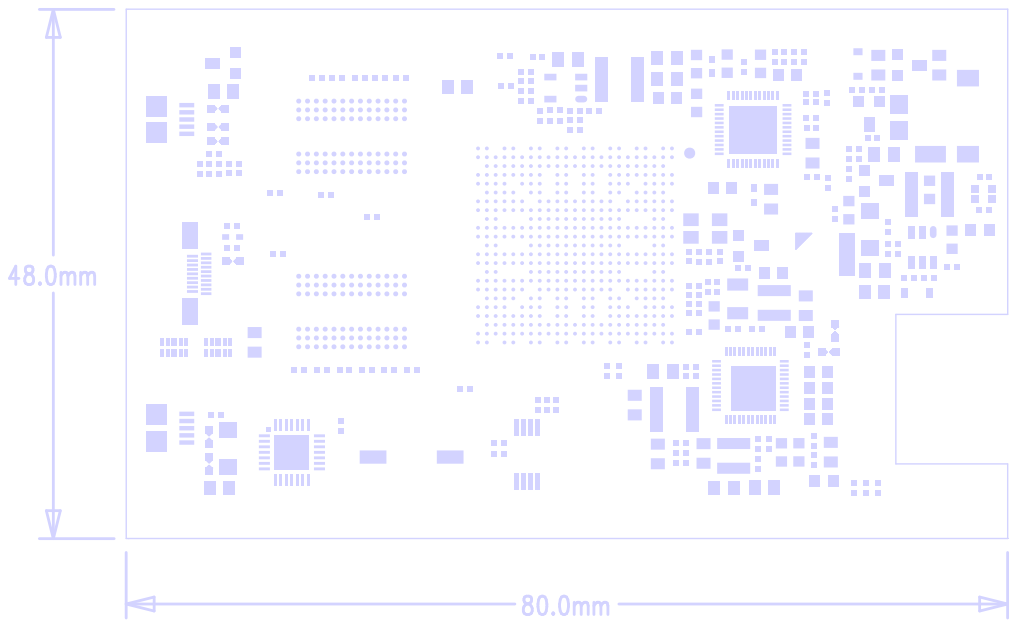
[picture p15: page 2]

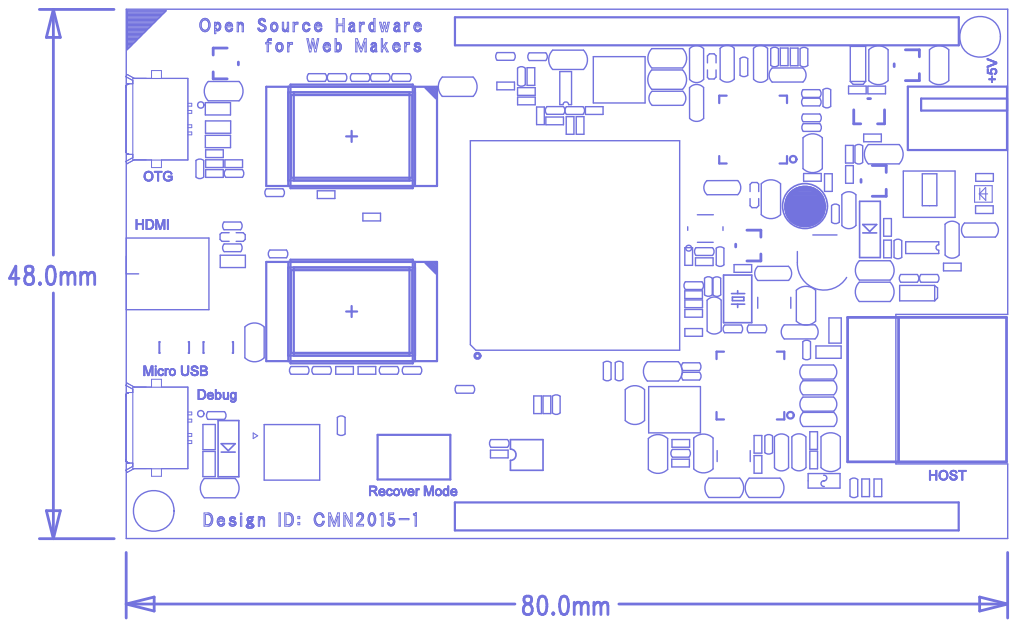
[picture p16: page 3]

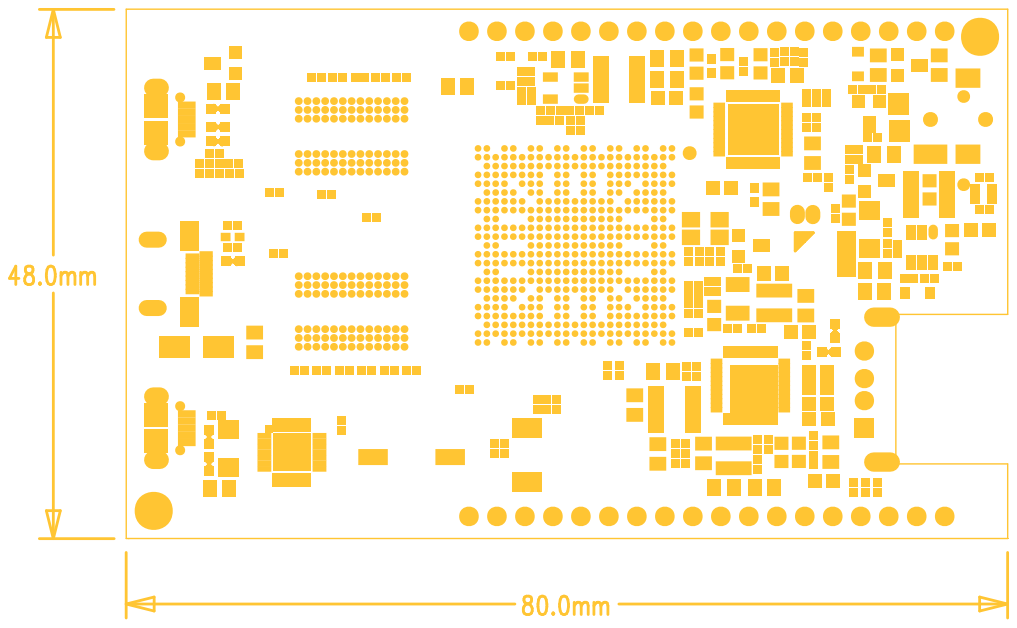
[picture p17: page 4]

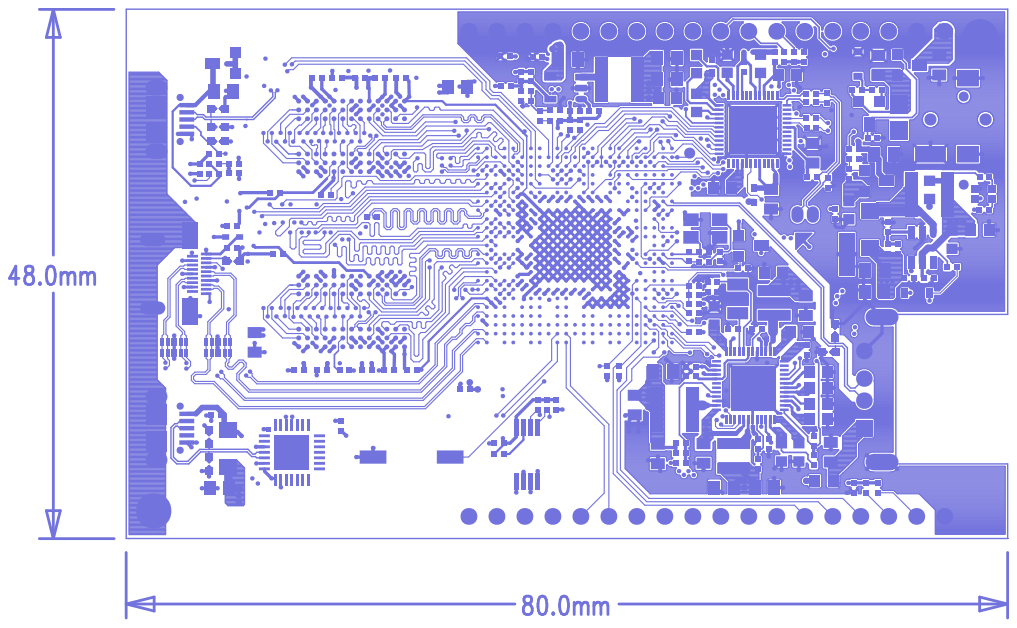
[picture p18: page 5]

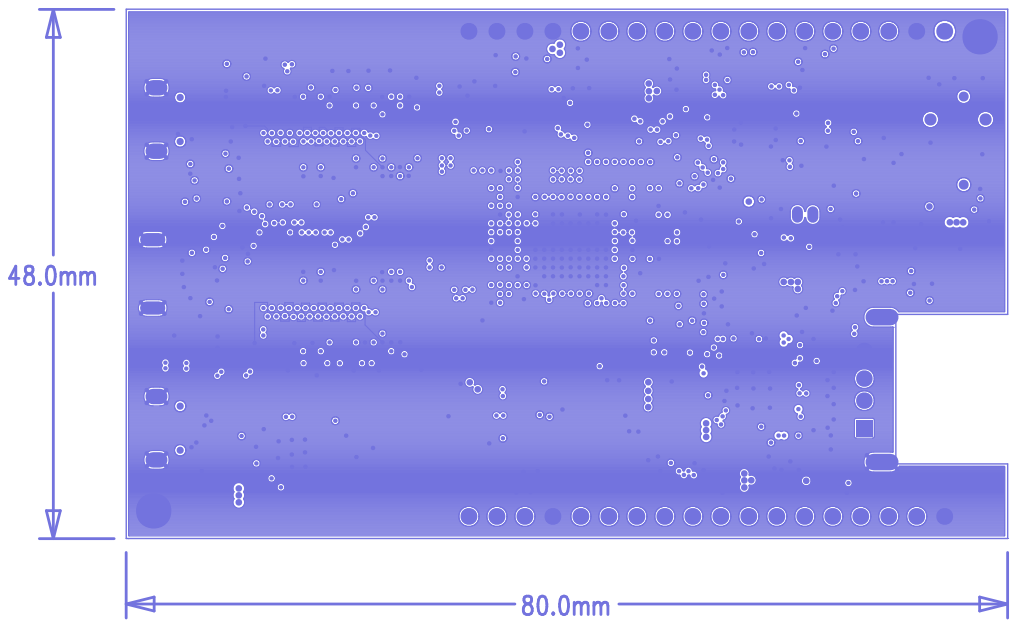
[picture p19: page 6]

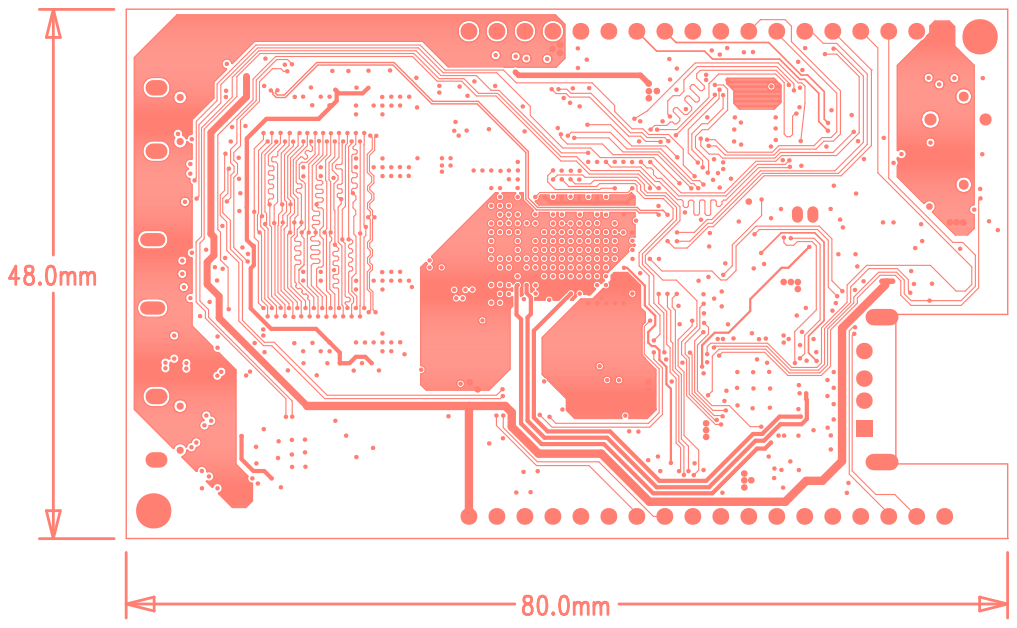
[picture p20: page 7]

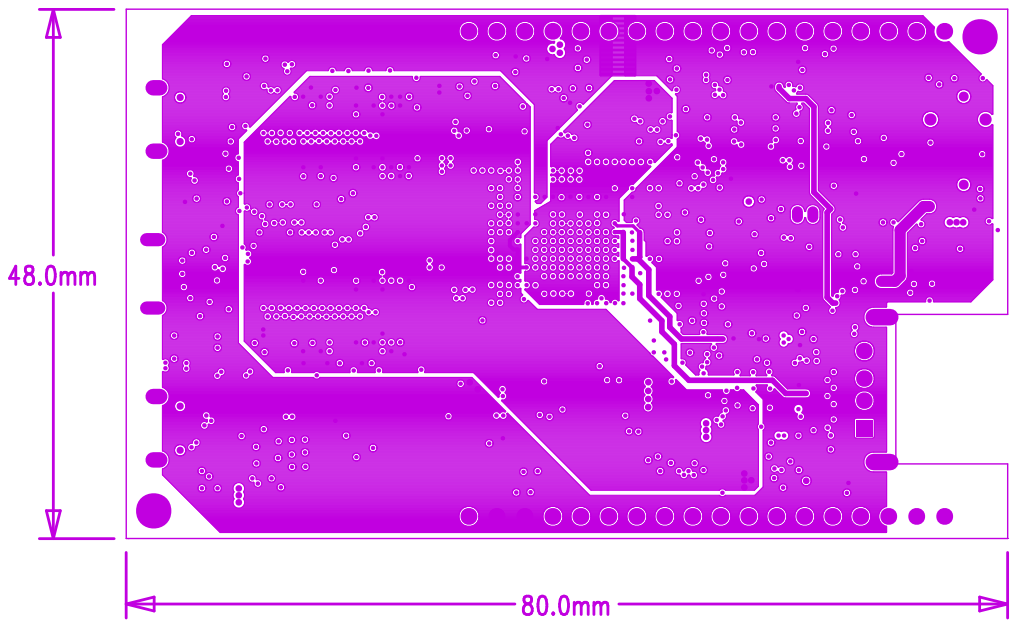
[picture p21: page 8]

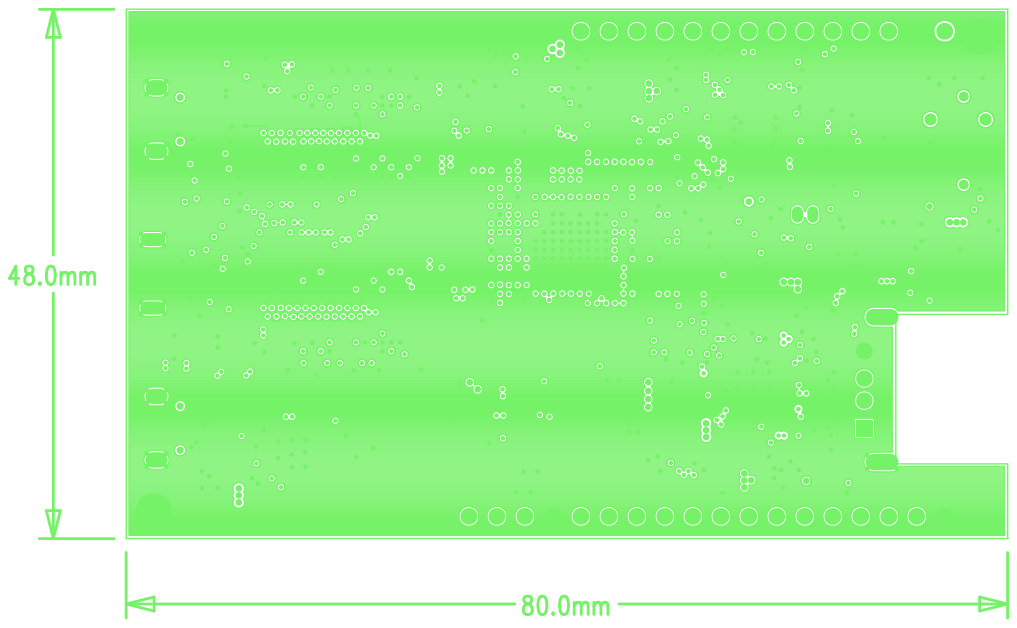
[picture p22: page 9]

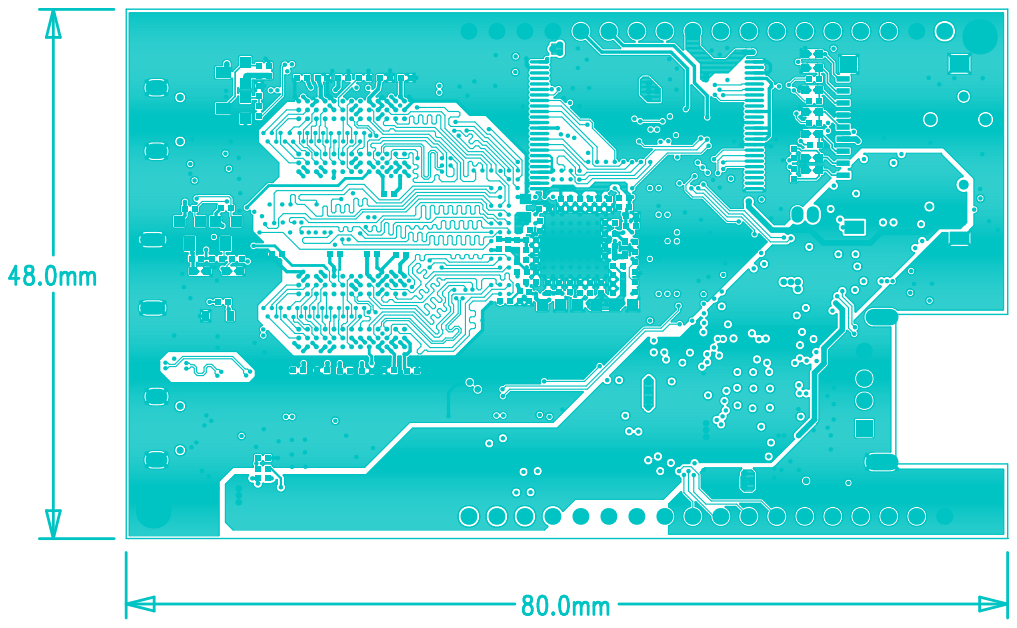
[picture p23: page 10]

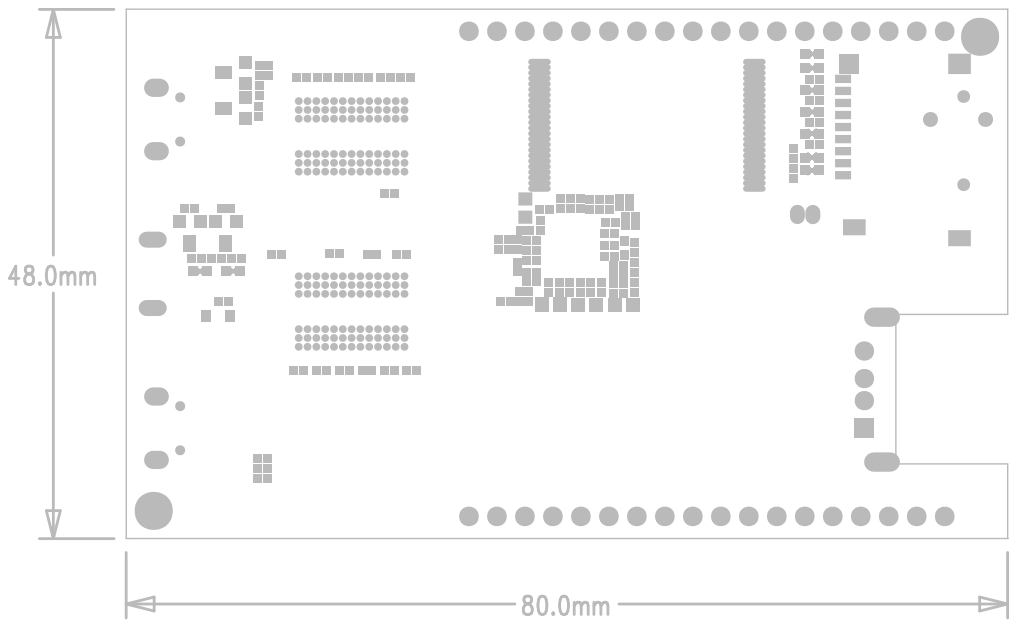
[picture p24: page 11]

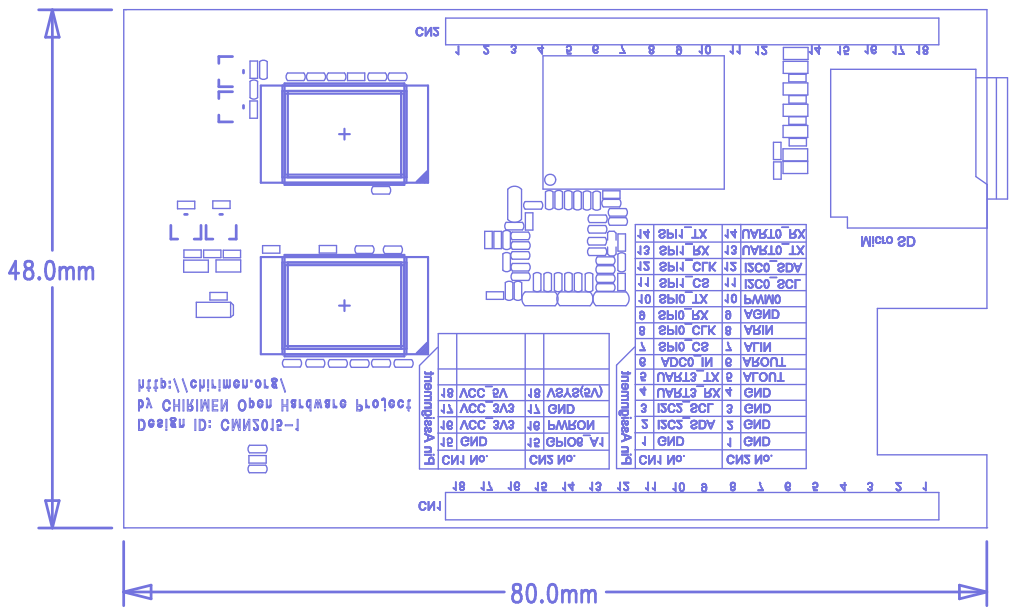
[picture p25: page 12]

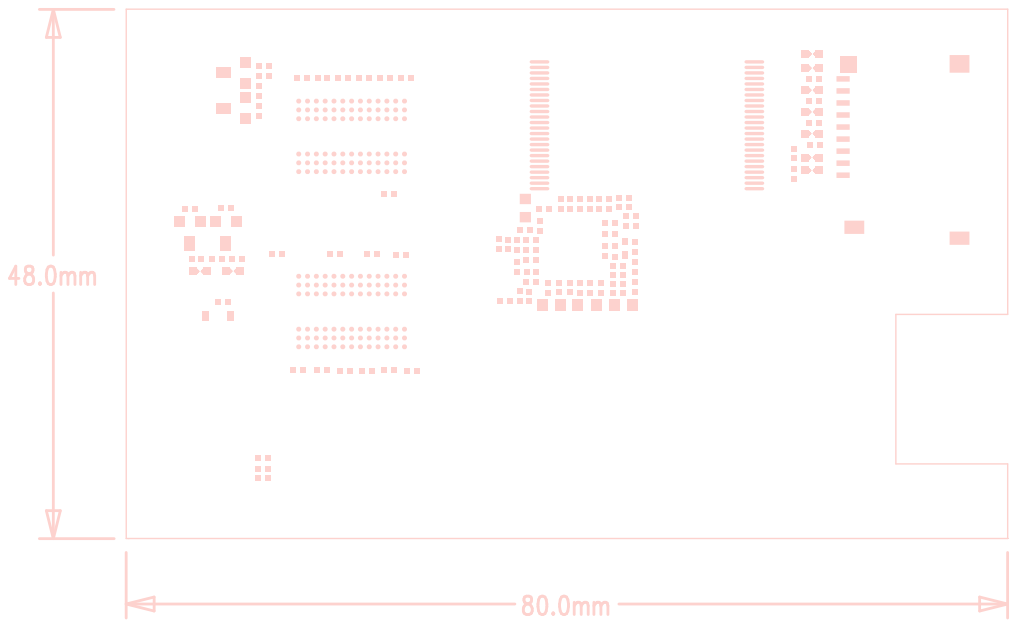
[picture p26: page 13]

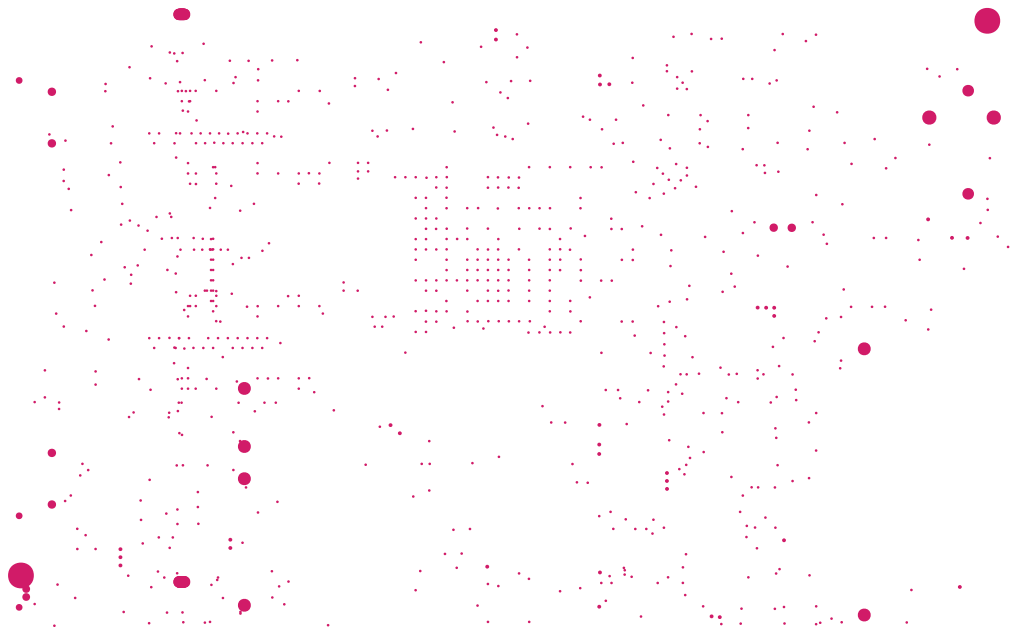
[picture p27: page 14]

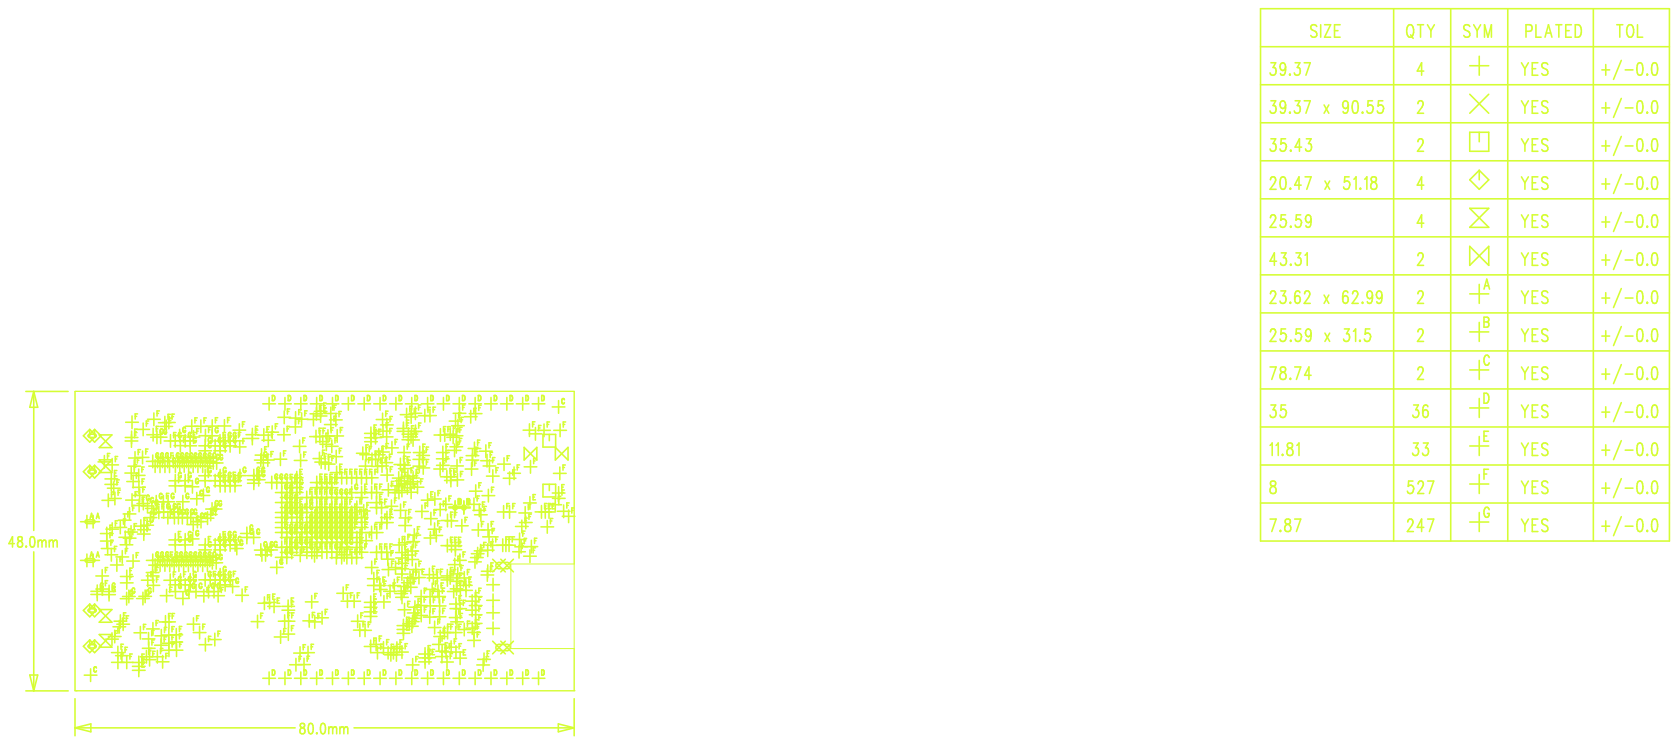
[picture p28: page 15]
