chirimen-oh/echigo-release/(list of files, drawings)

Other design files:
hardware/CMN2015-1.pcb
