chirimen-oh/echigo-release/(commit log)

2016-04-28 Add print pattern PDF of CMN2015-1
2016-04-28 Add gerber data of CMN2015-1
2016-04-28 Add CM2015-1 BOM xlsx
    [CMN2015-1_BOM.xlsx]
2016-04-28 Add CMN2015-1 BOM PDF
2016-04-28 Add CMN2015-1 schematic
2016-06-09 ADD PADS PCB File for CMN2015-1
    Thanks to Mr. kazutaka, we were able to edit the imperfect pcb file and register this file.
    [CMN2015-1.pcb]
